RHSResearchLLC/NiteFury-and-LiteFury/images/dsp-metrics.jpg

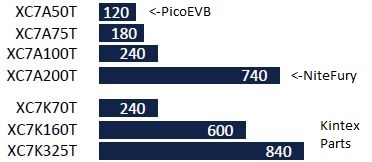
images/dsp-metrics.jpg
