RHSResearchLLC/NiteFury-and-LiteFury/images/on-gh.PNG

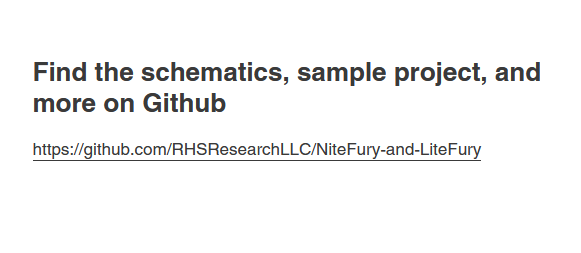
images/on-gh.PNG
