RHSResearchLLC/NiteFury-and-LiteFury/Hardware/uEVB-BOM-Z3.xlsx

RefDes | Quantity | Manufacturer | MPN | Value | Pattern | Name | Desc
C1, C15, C16, C17, C18, C19, C20, C21, C22, C23, C24, C25, C26, C44, C45, C130, C131, C132, C133, C140, C141 | 21 | Samsung | CL05A104JO5NNNC | 0.1uF | C_0402_least_A | CAP_0402 | CAP CER 0.1UF 10V X5R 0402
C2, C3, C4, C27, C28, C29, C30, C56, C57, C58, C59, C68, C69, C70, C71, C72, C73, C74, C75, C87, C88, C89, C90, C91, C92, C96, C97, C98, C99, C100, C103, C104, C105, C108, C109, C110, C111, C114, C115, C116, C117, C120, C121, C122, C123 | 45 | Murata | GRM152R60J474ME15D | 0.47uF | C_0402_least_C | CAP_0402 | CAP CER 0.47UF 6.3V X5R 0402
C5 | 1 | Murata | GJM1555C1H100JB01D | 10pF | C_0402_least | CAP_0402 | CAP CER 10PF 50V C0G/NP0 0402
C6 | 1 | Samsung | CL05C221JB51PNC | 220pF | C_0402_least | CAP_0402 | CAP CER 220PF 50V C0G/NP0 0402
C7, C8, C13, C40, C126, C128, C129, C137, C138, C144, C145, C146, C147 | 13 | Samsung | GRM188R60J476ME15D | 47uF | C_0603_least | CAP_0603 | CAP CER 47UF 6.3V X5R 0603
C9, C10, C11 | 3 | TDK | C1608X5R0J226M080AC | 22uF | C_0603_least | CAP_0603 | CAP CER 22UF 6.3V X5R 0603
C12, C14, C43 | 3 | Kemet | C0402C224K9PAC7867 | 0.22uF | C_0402_least | CAP_0402 | CAP CER 0.22UF 6.3V X5R 0402
C31, C32, C33, C34, C35, C76, C77, C78, C79, C80, C81, C82, C83, C84, C85, C86, C93, C94, C95, C101, C102, C106, C107, C112, C113, C118, C119, C124, C125, C127, C134 | 30 | Murata | GRM153R60J475ME15D | 4.7uF | C_0402_least_B | CAP_0402 | CAP CER 4.7UF 6.3V X5R 0402
C36, C37 | 2 | AVX | F950J107MPAAQ2 | 100uF | CAP_0805 | CAP_0805 | CAP TANT 100UF 6.3V 0805
C38, C39, C41, C42, C54, C55 | 6 | Murata | GRM152R60J105ME15D | 1uF | C_0402_least | CAP_0402 | CAP CER 1UF 6.3V X5R 0402
C46, C47, C48, C49, C50, C51, C52, C53, C60, C61, C62, C63, C64, C65, C66, C67 | 16 | Yageo | CC0201MRX5R5BB104 | 0.1uF | C_0201_least | CAP_0201 | CAP CER 0.1UF 10V X5R 0201
C135, C136 | 2 | Panasonic | ETPH220MABC | 220uF | CAP_1206 | CAP_1206 | CAP TANT POLY 220UF 2.5V 1206
C143 | 1 | Murata | GCM1555C1H220JA16D | 22pF | C_0402_least | CAP_0402 | CAP CER 22PF 50V C0G/NP0 0402
D1 | 1 | Kingbright | APHHS1005SURCK | NOT READY | LED_0402_least | LED-0402
D2, D5, D6, D7, D8 | 5 | Kingbright | APHHS1005CGCK | POWER | LED_0402_least | LED-0402
J1 | 1 | HRS | DF52-20S-0.8H(21) | DF52-20 | DF52-20 | DF52-20
L3, L4 | 2 | Bourns | SRP2510A-R22M | 220nH | L_1008 | L_1008
MH1, MH2, MH3 | 3 |  | DNP | DNP
P1, P2 | 2 | Molex | 78171-5006 |  | PicoEZ-6 | PicoEZMate
P3 | 1 | Molex | 781710002 |  | PicoEZ-2 | PicoEZ-2
P4 | 1 |  |  |  | ACES_3PIN_0.8 | Aces_3
R1, R11, R12, R13, R14, R15 | 6 | Panasonic | ERJ-2RKF49R9X | 49.9 1% | R_0402_least | RES_0402 | RES SMD 49.9 OHM 1% 1/10W 0402
R2, R8, R17, R18, R23, R24 | 6 | Panasonic | ERJ-2RKF6810X | 681 | R_0402_least | RES_0402 | RES SMD 681 OHM 1% 1/10W 0402
R3 | 1 | Panasonic | ERJ-2RKF8871X | 8.87K 0.1% | R_0402_least | RES_0402 | RES SMD 8.87K OHM 1% 1/10W 0402
R4, R25, R30, R31 | 4 | Samsung | RC1005F103CS | 10K 1% | R_0402_least | RES_0402 | RES SMD 10K OHM 1% 1/16W 0402
R5 | 1 | Samsung | RC0603F241CS | 240 1% | R_0201_least | RES_0201 | RES SMD 240 OHM 1% 1/20W 0201
R6, R7, R19, R21, R27, R29, R32 | 7 | Panasonic | ERJ-2RKF4701X | 4.7K | R_0402_least | RES_0402 | RES SMD 4.7K OHM 1% 1/10W 0402
R9, R20 | 1 | Panasonic | ERJ-2RKF1000X | 100 | R_0402_least | RES_0402 | RES SMD 100 OHM 1% 1/10W 0402
R10 | 1 | CTS | RT2402B7TR7 |  | RT24_3x9 | RT2402B7
R16 | 1 | Yageo | RC0201FR-07100RL | 100 | R_0201_least | RES_0201 | RES SMD 100 OHM 1% 1/20W 0201
R22 | 1 | Yageo | RC0402FR-07100KL | 100K 1% | R_0402_least | RES_0402 | RES SMD 100K OHM 1% 1/16W 0402
R26 | 1 | Yageo | RC0402FR-076K98L | 6.98K 1% | R_0402_least | RES_0402 | RES SMD 6.98K OHM 1% 1/16W 0402
R28 | 1 | Yageo | RC0402FR-0713KL | 13K | R_0402_least | RES_0402 | RES SMD 13K OHM 1% 1/16W 0402
TP1-TP18 | 1 |  | DNP | DNP
U1 | 1 | Maxim | MAX1589AETT100+T |  | MAX1589AETT | MAX1589AETT100+T
U2 | 1 | TI | TPS826711SIPR |  | TPS8267x | TPS826711SIPR
U3 | 1 | TI | TPS82085SILR |  | TPS82085 | TPS82085SILR
U5 | 1 | TI | TPS51206DSQ |  | TPS51206 | TPS51206DSQR
U6 | 1 |  | IS43TR16256AL-125KBL |  | TWBGA-96_9X13 | SDRAM x16
U7 | 1 | Xilinx | XC7A200T-3FBG484E |  | BGA-484/22x22x1_23x23 | XC7A200T_FBG484
U8 | 1 | Cypress | S25FL128SAGBHI210 |  | S25FLxxxxxxxxx2xx | S25FL128SAGBHI210
U9 | 1 |  | DNP | DNP
U10 | 1 | Microchip | DSC1001DL2-090.0000 | DSC1001 90MHz | XTAL-2.5x2 | DSC1001
U11 | 1 | TI | TPS82695SIPR |  | TPS8267x | TPS82695
U12 | 1 | TI | TPS8268120SIPR |  | TPS8268120 | TPS8268120
U13 | 1 | ADI | LTC3636EUFD#PBF |  | LTC3636 | LTC3636
X1 | 1 | Abracon | ASDMPLV-200.000MHZ-LR-T | ASDMPLV-200MHZ | XTAL-2.5x2-6 | OSC-6
