RHSResearchLLC/NiteFury-and-LiteFury/(threads)

Thread 2 (2019-09-22):

Enable over-temperature shutdown

HackerFoo, 2019-09-22:
It might be a good idea to enable over-temperature shutdown for Project-0:
```
# XDC Constraint
set_property BITSTREAM.CONFIG.OVERTEMPPOWERDOWN ENABLE [current_design]
```

Which I think is the same as: Edit Device Properties > Configuration > Enable over-termperature shutdown = ENABLE

RHSResearchLLC, 2019-10-29:
Agreed, this is a good idea. I've added the constraint- I'll be checking in new MCS soon. Thanks.

Closed 2019-10-29.

Thread 3 (2019-12-21):

problem during read from c2h in dma-test.py file

shahbaazlokh, 2019-12-21:
Here is the snippet of error:-
"
#0
Sent in 1386.4996433258057 milliseconds (774.4263254366286 MBPS)
Traceback (most recent call last):
  File "dma-test-2.py", line 82, in <module>
    main()
  File "dma-test-2.py", line 69, in main
    mem_test_random()
  File "dma-test-2.py", line 41, in mem_test_random
    rx_data.append(os.pread(fd_c2h, TRANSFER_SIZE, page * TRANSFER_SIZE))
OSError: [Errno 512] Unknown error 512
"
i think this a driver problem,
as i have also tested dma-test.py using earlier drivers from AR65444, c2h hangs in limbo while using this drivers,

Closed 2020-09-03.

Thread 4 (2020-01-25):

Simpler samples please

ianhan, 2020-01-25:
Hi,
This project is really cool but I wasn't expecting the only sample design to be 100% schematic - it would be cool if you could add a sample "golden" top project that consists of an empty verilog top module that implements all of the signals.
Thanks. Thanks for making this cool piece of kit!

mayureshw, 2023-10-28:
I am also looking for a simple sample design. Something like taking the xdma IP xci from the sample project and doing minimal things like loopback with it.

No matter what I try I end up with "!!! Unknown header type 7f" on transferring bitstream to the fpga (and doing rescan also).

I have taken a post implementation checkpoint and dumped the constraints from it just to ensure that those in early.xdc are valid. They are.

What else shall I be checking? Have spent several days in this state and am really at the end of my wits.

RHSResearchLLC, 2023-10-28:
@mayureshw "!!! Unknown header type 7f" happens when the device was on the PCIe bus, then drops off, then comes back on. You can't reprogram the bitstream while the device is on the PCIe bus and expect it to work. I've actually never seen a rescan work, although some people claimed it works for them. For rescan to work you need bios and motherboard support and most just don't implement it.

Really the only reliable way to work on a PCIe bitstream is to have the bitstream loaded from flash at powerup, ready when the motherboard/bios enumerates it, and don't reset/reload the FGPA after. So build your design (with any ILA), create MCS, load into flash, reboot, debug.

As far as a simpler design, the example design is about as simple as it gets. Sure you can delete some the of stuff that reads I/O.

mayureshw, 2023-10-29:
Let's say "mybitstream.bit" is my own design and "stock.bit" is a bitstream built from the sample project design.

I am using JTAG cable to program the device.

If I load, say, "mybitstream.bit" the "Unknown header type" occurs on lspci. But immediately after that if I load "stock.bit", the issue goes away. So, I think you can reprogram the device over JTAG. It is something in the design that keeps "mybitstream.bit" from working.

My Linux kernel is 6.3.13_1 and I am using Void Linux.

For simpler design, yes, that's precisely what I am doing. I have taken xdma configuration (xci file) from the sample project, with early and normal constraints, applied in proper order and verified that they got applied by taking a post-implementation checkpoint and writing out xdc.

With this I expect that lspci merely lists the device properly.

Incidentally there are two xci files for xdma, which confused me a bit:

project.srcs/sources_1/bd/Top/ip/Top_xdma_0_0/Top_xdma_0_0.xci

and

project.srcs/sources_1/bd/Top/ip/Top_xdma_0_0_1/Top_xdma_0_0.xci

Later I saw Top.bd refers to the latter, so that might be the one to pick.

Following is the difference between their properties (right side being the latter one).

`                                                              > all_speeds_all_sides NO
axil_master_64bit_en false                                    | axil_master_64bit_en true
axil_master_prefetchable false                                | axil_master_prefetchable true
axilite_master_scale Megabytes                                | axilite_master_scale Kilobytes
axilite_master_size 1                                         | axilite_master_size 128
                                                              > enable_pcie_debug_ports False
mode_selection Basic                                          | mode_selection Advanced
pf0_base_class_menu Simple_communication_controllers          | pf0_base_class_menu Device_was_built_before_Class_Code_defini
pf0_class_code 070001                                         | pf0_class_code 120000
pf0_class_code_base 07                                        | pf0_class_code_base 12
pf0_class_code_interface 01                                   | pf0_class_code_interface 00
pf0_device_id 7024                                            | pf0_device_id 7011
pf0_msix_cap_pba_bir BAR_1                                    | pf0_msix_cap_pba_bir BAR_3:2
pf0_msix_cap_table_bir BAR_1                                  | pf0_msix_cap_table_bir BAR_3:2
                                                              > pf0_pm_cap_pmesupport_d0 false
                                                              > pf0_pm_cap_pmesupport_d1 false
                                                              > pf0_pm_cap_pmesupport_d3hot false
                                                              > pf0_pm_cap_supp_d1_state false
pf0_sub_class_interface_menu 16450_compatible_serial_controll | pf0_sub_class_interface_menu All_currently_implemented_device
pf0_subsystem_id 0007                                         | pf0_subsystem_id 0
pf0_subsystem_vendor_id 10EE                                  | pf0_subsystem_vendor_id 0
xdma_pcie_64bit_en false                                      | xdma_pcie_64bit_en true
xdma_pcie_prefetchable false                                  | xdma_pcie_prefetchable true
`

mayureshw, 2023-10-29:
One more observation that shows that the new bitstream indeed is what lspci is reporting, I can spot a few small differences between the lspci output of the factory set device and after transferring out.bin. (I expected them to be same, but somehow there are these minor differences.)

<< is factoey set and >> is after transferring out.bin

2c2                                                                                                                                                                                 <       Control: I/O- Mem+ BusMaster+ SpecCycle- MemWINV- VGASnoop- ParErr- Stepping- SERR- FastB2B- DisINTx-                                                                       ---                                                                                                                                                                                 >       Control: I/O- Mem- BusMaster- SpecCycle- MemWINV- VGASnoop- ParErr- Stepping- SERR- FastB2B- DisINTx-                                                                       4d3                                                                                                                                                                                 <       Latency: 0                                                                                                                                                                  7,8c6,7
<       Region 0: Memory at 611c100000 (64-bit, prefetchable) [size=128K]                                                                                                           <       Region 2: Memory at 611c120000 (64-bit, prefetchable) [size=64K]                                                                                                            ---                                                                                                                                                                                 >       Region 0: Memory at 611c100000 (64-bit, prefetchable) [disabled] [size=128K]                                                                                                >       Region 2: Memory at 611c120000 (64-bit, prefetchable) [disabled] [size=64K]                                                                                                 18,19c17,18                                                                                                                                                                         <                       RlxdOrd+ ExtTag+ PhantFunc- AuxPwr- NoSnoop+                                                                                                                <                       MaxPayload 256 bytes, MaxReadReq 512 bytes                                                                                                                  ---                                                                                                                                                                                 >                       RlxdOrd+ ExtTag- PhantFunc- AuxPwr- NoSnoop+                                                                                                                >                       MaxPayload 128 bytes, MaxReadReq 512 bytes

mayureshw, 2023-10-29:
My apologies if the diff output in above two posts looks a little awry. When editing it looks alright and later it messes up with the formating.

Thread 5 (2020-08-05):

Will this work without a heatsink?

shawnl, 2020-08-05:
That massive heatsink will not fit in my thinkpad. On the other hand it has a steel case that it would rest against, and you merged the poweroff on overheat patch.

RHSResearchLLC, 2020-08-13:
Probably not. The Artix FPGAs seem to run hot. Maybe if your bitstream is low power, and you drop to 1 PCIe lane instead of 4, you might have a chance.

Closed 2020-08-13.

Thread 7 (2020-08-20):

PCB design

mmehari, 2020-08-20:
Hi,
Is it possible to have a PCB design of this project, similar to the Kicad project of PicoEVB?

Thanks

RHSResearchLLC, 2020-08-29:
Hello,

I'm not ready to release the PCB design at this time. Plus its a DipTrace project, which isn't as useful as the open-source KiCad project.

Closed 2020-08-29.

Thread 8 (2020-08-30):

Configuring LiteFury

lleon95, 2020-08-30:
Hi,

I am trying to configure the LiteFury with an FT232R connected to the JTAG port of the FPGA. I chose a 3.3V configuration and wiring the FT232R based on the following schematic: http://vak.ru/doku.php/proj/bitbang/bitbang-jtag and the JTAG port pinout from the Litefury [datasheet](https://github.com/RHSResearchLLC/NiteFury-and-LiteFury/blob/master/Hardware/uEVB.pdf).

I installed and built the `xvcd` and it successfully detects the FT232 device similar as I already did for a PicoEVB built-in FT232 device. However, when I connect through Vivado on a remote machine, it tells me that it doesn't detect any Xilinx device within the port (given by `xvcd`).

I would like to ask if you have an example for FT232R wiring to the JTAG port, or in the case, suggest a device to program the Litefury. I connected the Litefury to the PCIe port for NVMM in a Xavier NX, where I am also connecting the FTDI device.

I also want to highlight that I connected the Litefury to the FTDI through the JTAG port without connecting the whole module to the Xavier and a red lights blinked periodically.

Thanks in advance

RHSResearchLLC, 2020-09-03:
Hello,
Unfortunately, I don't have any experience with the FT232R. I use FT230X on PicoEVB, and I've used FT232H with success (but that code uses the MPSSE, not bitbang). I'm sorry I can't be more help.

For programming I usually use Digilent HS1/HS2/HS3. Can usually find them at a decent price

lleon95, 2020-09-03:
Hi. I just wanted to mention I managed to solve the issue. I used this pinout:

```
      -FTDI-  -JTAG-
    -  RXD  -  TDI
    -  TXD  -  TCK
    -  RTS  -  TDO
    -  CTS  -  TMS
    -  DTR  -  TRST
    -  DCD  -  SRST
```

With that, I was able to use the XVCD to configure the Litefury.

Regards,
Leon.

RHSResearchLLC, 2020-09-03:
Awesome thanks for the info!

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

Closed 2020-09-03.

Thread 9 (2020-09-02):

Insufficient mounting stability of 6-pin EZmate connectors

eqvinox, 2020-09-02:
Hiya,

I just managed to tear one of the 6-pin EZmate connectors off the small JTAG adapter boards. Details:

- didn't really use force, used to dealing with small flimsy hardware
- the connector only came off about halfway; both of the side retention pins plus 3 or 4 of the data pins
- the pads were *not* ripped off, it seems the solder connection itself was the weak point
- I successfully soldered it back on manually, but burned some plastic on the JTAG connector since the positioning is awkward

I checked my other adapter (I ordered 2 boards) and at first it seemed to be better, but then on that board also one of the side retention pins came off in the same way, and after this happened the connector doesn't unplug properly anymore (lifts the socket instead.) It seems that as soon as one of the side pins is gone, you're kinda f*cked and the entire thing cascade-fails.

I see 3 possible causes here:

- the solder pads or mask are too small so the solder connection is too weak
- the connectors fundamentally are badly designed (ed.: by Molex, I mean) with a very small area of force transfer
- just bad luck, either on the boards or on my use of them

I'm posting this here as a reference/warning and collection point in case other people have the same problem. I haven't tried/checked this on the actual FPGA boards since I'd rather not break them. Presumably the footprint is the same there, though maybe not the assembly procedure?

Either way it might be a good idea to double check mounting details on these connectors and maybe increase the size of the pads and solder mask opening for the mechanical/mounting pins at the side.

Cheers!

RHSResearchLLC, 2020-09-03:
Hello Hiya,

The issue here is that the first batch (~50 pcs) of the adapter boards were made using low-temp bismuth solder, to prevent the 14-pin connector from melting. Unfortunately, it seems this solder can shear with low force. Bismuth solder was chosen because the assembly has to be lead free for EU, and the 14-pin connector's plastic body would melt at the temperatures required for "standard" (SAC305) lead-free solder.

All subsequent batches use a better 14-pin connector and SAC305 solder, and the solder joint is very strong. The LiteFury/NiteFury itself has always used SAC305 solder so there is no danger of ripping off the connector.

To anyone who experiences this issue, email dave@rhsresearch.com with your address and I'll send you a replacement adapter for free.

eqvinox, 2020-09-07:
> and the 14-pin connector's plastic body would melt at the temperatures required

Can confirm %-)

> The LiteFury/NiteFury itself has always used SAC305 solder so there is no danger of ripping off the connector.

Awesome, very glad to hear that!  That was my primary concern.

> To anyone who experiences this issue, email dave@rhsresearch.com with your address and I'll send you a replacement adapter for free.

Great!  Funnily enough I don't even need the adapter (nothing else I have has 14-pin 2mm JTAG), I was kinda just playing around with it to see how the 6-pin connector works.  So that's 2 pcs that don't need to be replaced.

Closed 2023-10-17.

Thread 10 (2021-02-01):

run_tests.sh locks host machine

BoneGoat, 2021-02-01:
Hi,

I'm running the NiteFury on a RockPi4 (ARM). I had to recompile everything but after that step the kernel module loaded and everything seemed fine. When I ran run_tests.sh the whole machine locked up. Lights are still blinking on the NiteFury but the machine is non responsive. What may cause this?

lspci -vv

01:00.0 Serial controller: Xilinx Corporation Device 7024 (prog-if 01 [16450])
	Subsystem: Xilinx Corporation Device 0007
	Control: I/O- Mem- BusMaster- SpecCycle- MemWINV- VGASnoop- ParErr- Stepping- SERR- FastB2B- DisINTx-
	Status: Cap+ 66MHz- UDF- FastB2B- ParErr- DEVSEL=fast >TAbort- <TAbort- <MAbort- >SERR- <PERR- INTx-
	Interrupt: pin A routed to IRQ 234
	Region 0: Memory at fa000000 (32-bit, non-prefetchable) [disabled] [size=1M]
	Region 1: Memory at fa100000 (32-bit, non-prefetchable) [disabled] [size=64K]
	Capabilities: [40] Power Management version 3
		Flags: PMEClk- DSI- D1- D2- AuxCurrent=0mA PME(D0+,D1+,D2+,D3hot+,D3cold-)
		Status: D0 NoSoftRst+ PME-Enable- DSel=0 DScale=0 PME-
	Capabilities: [48] MSI: Enable- Count=1/1 Maskable- 64bit+
		Address: 0000000000000000  Data: 0000
	Capabilities: [60] Express (v2) Endpoint, MSI 00
		DevCap:	MaxPayload 512 bytes, PhantFunc 0, Latency L0s <64ns, L1 unlimited
			ExtTag+ AttnBtn- AttnInd- PwrInd- RBE+ FLReset- SlotPowerLimit 0.000W
		DevCtl:	Report errors: Correctable- Non-Fatal- Fatal- Unsupported-
			RlxdOrd+ ExtTag- PhantFunc- AuxPwr- NoSnoop+
			MaxPayload 128 bytes, MaxReadReq 512 bytes
		DevSta:	CorrErr- UncorrErr- FatalErr- UnsuppReq- AuxPwr- TransPend-
		LnkCap:	Port #0, Speed 5GT/s, Width x4, ASPM L0s, Exit Latency L0s unlimited, L1 unlimited
			ClockPM- Surprise- LLActRep- BwNot- ASPMOptComp-
		LnkCtl:	ASPM Disabled; RCB 64 bytes Disabled- CommClk-
			ExtSynch- ClockPM- AutWidDis- BWInt- AutBWInt-
		LnkSta:	Speed 2.5GT/s, Width x4, TrErr- Train- SlotClk+ DLActive- BWMgmt- ABWMgmt-
		DevCap2: Completion Timeout: Range B, TimeoutDis-, LTR-, OBFF Not Supported
		DevCtl2: Completion Timeout: 50us to 50ms, TimeoutDis-, LTR-, OBFF Disabled
		LnkCtl2: Target Link Speed: 5GT/s, EnterCompliance- SpeedDis-
			 Transmit Margin: Normal Operating Range, EnterModifiedCompliance- ComplianceSOS-
			 Compliance De-emphasis: -6dB
		LnkSta2: Current De-emphasis Level: -3.5dB, EqualizationComplete-, EqualizationPhase1-
			 EqualizationPhase2-, EqualizationPhase3-, LinkEqualizationRequest-
	Capabilities: [100 v1] Device Serial Number 00-00-00-00-00-00-00-00

sudo ./load_driver.sh

Loading xdma driver...
The Kernel module installed correctly and the xmda devices were recognized.
 DONE

dmesg

[ 7641.378840] xdma: loading out-of-tree module taints kernel.
[ 7641.382338] xdma:xdma_mod_init: Xilinx XDMA Reference Driver xdma v2017.1.47
[ 7641.382351] xdma:xdma_mod_init: desc_blen_max: 0xfffffff/268435455, sgdma_timeout: 10 sec.
[ 7641.383695] xdma:xdma_device_open: xdma device 0000:01:00.0, 0xffffffc0ed638800.
[ 7641.383731] xdma 0000:01:00.0: enabling device (0000 -> 0002)
[ 7641.383757] xdma:pci_check_extended_tag: 0xffffffc0ed638800 EXT_TAG disabled.
[ 7641.383765] xdma:pci_check_extended_tag: pdev 0xffffffc0ed638800, xdev 0xffffffc0e8568000, config bar UNKNOWN.
[ 7641.383931] xdma:map_single_bar: BAR0 at 0xfa000000 mapped at 0xffffff800e400000, length=1048576(/1048576)
[ 7641.383969] xdma:map_single_bar: BAR1 at 0xfa100000 mapped at 0xffffff800bf80000, length=65536(/65536)
[ 7641.383980] xdma:map_bars: config bar 1, pos 1.
[ 7641.383987] xdma:identify_bars: 2 BARs: config 1, user 0, bypass -1.
[ 7641.384198] xdma:probe_one: 0000:01:00.0 xdma0, pdev 0xffffffc0ed638800, xdev 0xffffffc0dd202000, 0xffffffc0e8568000, usr 16, ch 1,1.
[ 7641.409170] xdma:cdev_xvc_init: xcdev 0xffffffc0dd203b88, bar 0, offset 0x40000.

sudo ./run_test.sh

Info: Number of enabled h2c channels = 1
Info: Number of enabled c2h channels = 1
Info: The PCIe DMA core is memory mapped.
Info: Running PCIe DMA memory mapped write read test
      transfer size:  1024
      transfer count: 1
Info: Writing to h2c channel 0 at address offset 0.
Info: Wait for current transactions to complete.

After this the system becomes unresponsive.

RHSResearchLLC, 2021-02-02:
This usually has 2 causes:
1) Old XDMA driver. Don't use the code thats part of this repo. I should probably delete it. You should use the XDMA code from Xilinx GitHub repo here: https://github.com/Xilinx/dma_ip_drivers/tree/master/XDMA/linux-kernel

2) Defective Litefury: If the DDR isn't responding for some reason, it hangs everything. There isn't an AXI timeout.

If you try the new driver and it doesn't solve the problem let me know, I'll send you another Litefury. The units are fully tested before they ship, but stuff happens.

RHSResearchLLC, 2021-02-02:
Also, the best way to get support is via emailing me (dave@rhsresearch.com).

BoneGoat, 2021-02-02:
Thanks for your reply! I built the driver from the repo you posted and it no longer hangs when running run_tests.sh. It does however complete with errors, should I be concerned?

Info: Number of enabled h2c channels = 1
Info: Number of enabled c2h channels = 1
Info: The PCIe DMA core is memory mapped.
Info: Running PCIe DMA memory mapped write read test
      transfer size:  1024
      transfer count: 1
Info: Writing to h2c channel 0 at address offset 0.
Info: Wait for current transactions to complete.
/dev/xdma0_h2c_0 ** Average BW = 1024, 5.287372
Info: Writing to h2c channel 0 at address offset 1024.
Info: Wait for current transactions to complete.
/dev/xdma0_h2c_0 ** Average BW = 1024, 3.657091
Info: Writing to h2c channel 0 at address offset 2048.
Info: Wait for current transactions to complete.
/dev/xdma0_h2c_0 ** Average BW = 1024, 3.771014
Info: Writing to h2c channel 0 at address offset 3072.
Info: Wait for current transactions to complete.
/dev/xdma0_h2c_0 ** Average BW = 1024, 3.803708
Info: Reading from c2h channel 0 at address offset 0.
Info: Wait for the current transactions to complete.
/dev/xdma0_c2h_0 ** Average BW = 1024, 3.376251
Info: Reading from c2h channel 0 at address offset 1024.
Info: Wait for the current transactions to complete.
/dev/xdma0_c2h_0 ** Average BW = 1024, 2.740687
Info: Reading from c2h channel 0 at address offset 2048.
Info: Wait for the current transactions to complete.
/dev/xdma0_c2h_0 ** Average BW = 1024, 4.069499
Info: Reading from c2h channel 0 at address offset 3072.
Info: Wait for the current transactions to complete.
/dev/xdma0_c2h_0 ** Average BW = 1024, 2.467690
Info: Checking data integrity.
data/output_datafile0_4K.bin data/datafile0_4K.bin differ: char 53, line 1
Error: The data written did not match the data that was read.
       address range:   0 - 1024
       write data file: data/datafile0_4K.bin
       read data file:  data/output_datafile0_4K.bin
data/output_datafile1_4K.bin data/datafile1_4K.bin differ: char 53, line 2
Error: The data written did not match the data that was read.
       address range:   1024 - 2048
       write data file: data/datafile1_4K.bin
       read data file:  data/output_datafile1_4K.bin
data/output_datafile2_4K.bin data/datafile2_4K.bin differ: char 54, line 2
Error: The data written did not match the data that was read.
       address range:   2048 - 3072
       write data file: data/datafile2_4K.bin
       read data file:  data/output_datafile2_4K.bin
data/output_datafile3_4K.bin data/datafile3_4K.bin differ: char 53, line 2
Error: The data written did not match the data that was read.
       address range:   3072 - 4096
       write data file: data/datafile3_4K.bin
       read data file:  data/output_datafile3_4K.bin
Error: Test completed with Errors.
Error: Test completed with Errors.

dmesg:
[  870.983951] xdma:xdma_mod_init: Xilinx XDMA Reference Driver xdma v2020.1.8
[  870.983965] xdma:xdma_mod_init: desc_blen_max: 0xfffffff/268435455, timeout: h2c 10 c2h 10 sec.
[  870.985805] xdma:xdma_device_open: xdma device 0000:01:00.0, 0xffffffc0ed678800.
[  870.985876] xdma 0000:01:00.0: enabling device (0000 -> 0002)
[  870.986124] xdma:map_single_bar: BAR0 at 0xfa000000 mapped at 0xffffff800e400000, length=1048576(/1048576)
[  870.986220] xdma:map_single_bar: BAR1 at 0xfa100000 mapped at 0xffffff800bec0000, length=65536(/65536)
[  870.986241] xdma:map_bars: config bar 1, pos 1.
[  870.986259] xdma:identify_bars: 2 BARs: config 1, user 0, bypass -1.
[  870.986728] xdma:pci_keep_intx_enabled: 0000:01:00.0: clear INTX_DISABLE, 0x406 -> 0x6.
[  870.986873] xdma:probe_one: 0000:01:00.0 xdma0, pdev 0xffffffc0ed678800, xdev 0xffffffc0eb376000, 0xffffffc0eb374000, usr 16, ch 1,1.
[  870.997049] xdma:cdev_xvc_init: xcdev 0xffffffc0eb377b88, bar 0, offset 0x40000.

RHSResearchLLC, 2021-02-02:
Tobias,

I don't think the XDMA test you are running will work with the factory
bitstream.

Can you try dma-test-2.py from here:
https://github.com/RHSResearchLLC/NiteFury-and-LiteFury/tree/master/Sample-Projects/Project-0/Host/Host

Best regards,

Dave.

On Tue, Feb 2, 2021 at 2:40 PM Tobias Björnsson <notifications@github.com>
wrote:

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

BoneGoat, 2021-02-08:
Hi, I tried the dma-test-2.py with the following results:

#0
Sent in 2190.97900390625 milliseconds (490.07399070719003 MBPS)
Traceback (most recent call last):
  File "dma-test-2.py", line 81, in <module>
    main()
  File "dma-test-2.py", line 68, in main
    mem_test_random()
  File "dma-test-2.py", line 41, in mem_test_random
    rx_data.append(os.pread(fd_c2h, TRANSFER_SIZE, page * TRANSFER_SIZE))
OSError: [Errno 512] Unknown error 512

Running it again locks up the host.

Error 512 sent me down a rabbit hole with the post here: https://forums.xilinx.com/t5/PCIe-and-CPM/debug-the-driver-of-IP-PCIE-with-DMA/m-p/1003427/highlight/true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

I tested the suggested solution but the test failed anyway:

Info: Number of enabled h2c channels = 1
Info: Number of enabled c2h channels = 1
Info: The PCIe DMA core is memory mapped.
Info: Running PCIe DMA memory mapped write read test
      transfer size:  1024
      transfer count: 1
Info: Writing to h2c channel 0 at address offset 0. TransferSize: 1024 TransferCount: 1
Info: Wait for current transactions to complete.
/dev/xdma0_h2c_0 ** Average BW = 1024, 3.382519
Info: Writing to h2c channel 0 at address offset 1024. TransferSize: 1024 TransferCount: 1
Info: Wait for current transactions to complete.
/dev/xdma0_h2c_0 ** Average BW = 1024, 2.005331
Info: Writing to h2c channel 0 at address offset 2048. TransferSize: 1024 TransferCount: 1
Info: Wait for current transactions to complete.
/dev/xdma0_h2c_0 ** Average BW = 1024, 3.795151
Info: Writing to h2c channel 0 at address offset 3072. TransferSize: 1024 TransferCount: 1
Info: Wait for current transactions to complete.
/dev/xdma0_h2c_0 ** Average BW = 1024, 3.331175
Info: Reading from c2h channel 0 at address offset 0. TransferSize: 1024 TransferCount: 1
Info: Wait for the current transactions to complete.
/dev/xdma0_c2h_0 ** Average BW = 1024, 3.323952
Info: Reading from c2h channel 0 at address offset 1024. TransferSize: 1024 TransferCount: 1
Info: Wait for the current transactions to complete.
/dev/xdma0_c2h_0 ** Average BW = 1024, 3.227494
Info: Reading from c2h channel 0 at address offset 2048. TransferSize: 1024 TransferCount: 1
Info: Wait for the current transactions to complete.
/dev/xdma0_c2h_0 ** Average BW = 1024, 3.982716
Info: Reading from c2h channel 0 at address offset 3072. TransferSize: 1024 TransferCount: 1
Info: Wait for the current transactions to complete.
/dev/xdma0_c2h_0 ** Average BW = 1024, 2.669127
Info: Checking data integrity.
data/output_datafile0_4K.bin data/datafile0_4K.bin differ: char 53, line 1
Error: The data written did not match the data that was read.
       address range:   0 - 1024
       write data file: data/datafile0_4K.bin
       read data file:  data/output_datafile0_4K.bin
data/output_datafile1_4K.bin data/datafile1_4K.bin differ: char 53, line 2
Error: The data written did not match the data that was read.
       address range:   1024 - 2048
       write data file: data/datafile1_4K.bin
       read data file:  data/output_datafile1_4K.bin
data/output_datafile2_4K.bin data/datafile2_4K.bin differ: char 54, line 2
Error: The data written did not match the data that was read.
       address range:   2048 - 3072
       write data file: data/datafile2_4K.bin
       read data file:  data/output_datafile2_4K.bin
data/output_datafile3_4K.bin data/datafile3_4K.bin differ: char 53, line 2
Error: The data written did not match the data that was read.
       address range:   3072 - 4096
       write data file: data/datafile3_4K.bin
       read data file:  data/output_datafile3_4K.bin
Error: Test completed with Errors.
Error: Test completed with Errors.

I'm not sure if the board is faulty or just not compatible with the RockPi4.

RHSResearchLLC, 2021-02-08:
OK, stick with dma-test-2.py. Reduce the transfer size and see if that
helps. Also, once you get that error (unknown error 512), the test won't
work properly. It seems to mess up the driver. So if you see that error 512
its best to reboot and try again. I see that error happen when the transfer
size is too large for the OS to handle.

Best regards,

Dave.

On Mon, Feb 8, 2021 at 2:53 PM Tobias Björnsson <notifications@github.com>
wrote:

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

BoneGoat, 2021-02-09:
Right, tested the following:

1. TRANSFER_SIZE = 512*512*4
2. TRANSFER_SIZE = 256*256*4
3. TRANSFER_SIZE = 128*128*4

All resulted in:

#0
Segmentation fault

dmesg from driver being loaded to the seg fault:

[  169.797974] xdma: loading out-of-tree module taints kernel.
[  169.801380] xdma:xdma_mod_init: Xilinx XDMA Reference Driver xdma v2020.1.8
[  169.801395] xdma:xdma_mod_init: desc_blen_max: 0xfffffff/268435455, timeout: h2c 10 c2h 10 sec.
[  169.802804] xdma:xdma_device_open: xdma device 0000:01:00.0, 0xffffffc0ed5e8000.
[  169.802838] xdma 0000:01:00.0: enabling device (0000 -> 0002)
[  169.803031] xdma:map_single_bar: BAR0 at 0xfa000000 mapped at 0xffffff800e400000, length=1048576(/1048576)
[  169.803070] xdma:map_single_bar: BAR1 at 0xfa100000 mapped at 0xffffff800bec0000, length=65536(/65536)
[  169.803081] xdma:map_bars: config bar 1, pos 1.
[  169.803089] xdma:identify_bars: 2 BARs: config 1, user 0, bypass -1.
[  169.803394] xdma:pci_keep_intx_enabled: 0000:01:00.0: clear INTX_DISABLE, 0x406 -> 0x6.
[  169.803474] xdma:probe_one: 0000:01:00.0 xdma0, pdev 0xffffffc0ed5e8000, xdev 0xffffffc0ed3e4000, 0xffffffc0ed3e6000, usr 16, ch 1,1.
[  169.809281] xdma:cdev_xvc_init: xcdev 0xffffffc0ed3e5b88, bar 0, offset 0x40000.
[  337.868732] Bad mode in Error handler detected, code 0xbf000002 -- SError
[  337.869330] Internal error: Oops - bad mode: 0 [#1] SMP
[  337.869795] Modules linked in: xdma(O) bcmdhd ip_tables x_tables autofs4
[  337.870437] CPU: 4 PID: 784 Comm: python3 Tainted: G           O    4.4.154-59-rockchip-g5e70f14 #4
[  337.871231] Hardware name: ROCK PI 4B (DT)
[  337.871592] task: ffffffc0ed236200 task.stack: ffffffc0eb854000
[  337.872113] PC is at 0x7f80e9a07c
[  337.872404] LR is at 0x47dc78
[  337.872673] pc : [<0000007f80e9a07c>] lr : [<000000000047dc78>] pstate: 40000000
[  337.873318] sp : 0000007ff1d237c0
[  337.873609] x29: 0000007ff1d237c0 x28: 000000003707bc80
[  337.874098] x27: 0000007f80b5d8a0 x26: 000000000047dbd0
[  337.874586] x25: 0000000000000003 x24: 0000000001e00000
[  337.875073] x23: 00000000007c9408 x22: 000000000085e570
[  337.875561] x21: 0000007f80a44480 x20: 0000000036c57ba0
[  337.876048] x19: 0000000000000003 x18: 00000000000002eb
[  337.876535] x17: 0000007f80e9a050 x16: 00000000007c6ad0
[  337.877022] x15: 0000007f80ddce08 x14: 0000007f80dea308
[  337.877510] x13: 000000006022e5a9 x12: 0000000000000018
[  337.877997] x11: 0000000000000000 x10: 0000007ff1d237c0
[  337.878484] x9 : 0000000000000001 x8 : 0000000000000044
[  337.878971] x7 : 0000000000000001 x6 : 0000000000000000
[  337.879458] x5 : 000000000000017f x4 : 0000007f80f31270
[  337.879946] x3 : 0000000001e00000 x2 : 0000000000100000
[  337.880433] x1 : 0000000038eab130 x0 : 0000000000100000
[  337.881062] Process python3 (pid: 784, stack limit = 0xffffffc0eb854000)
[  337.881696] ---[ end trace 3a0bab8d539be790 ]---

RHSResearchLLC, 2021-02-09:
Doesn't look like enough information to really help. Probably the last thing you could try

BoneGoat, 2021-02-10:
OK, thanks Dave for all your help!

Closed 2021-02-10.

Thread 11 (2021-02-15):

Failed to detect XDMA config BAR

spaceotter, 2021-02-15:
I'm having some trouble with my NiteFury card and top-of-master [XDMA](https://github.com/Xilinx/dma_ip_drivers). It works when plugged into a PCIe switch card: https://www.amazon.com/gp/product/B08L8J3MBT/ with some occasional reliability issues. But when plugged into the mother board with a M.2 adapter, the driver doesn't work.

<details>
<summary>lspci -d 10ee: -vvv</summary>

```
4b:00.0 Serial controller: Xilinx Corporation Device 7024 (prog-if 01 [16450])
	Subsystem: Xilinx Corporation Device 0007
	Control: I/O- Mem- BusMaster- SpecCycle- MemWINV- VGASnoop- ParErr- Stepping- SERR- FastB2B- DisINTx-
	Status: Cap+ 66MHz- UDF- FastB2B- ParErr- DEVSEL=fast >TAbort- <TAbort- <MAbort- >SERR- <PERR- INTx-
	Interrupt: pin A routed to IRQ 193
	Region 0: Memory at d0300000 (32-bit, non-prefetchable) [virtual] [size=1M]
	Region 1: Memory at d0400000 (32-bit, non-prefetchable) [virtual] [size=64K]
	Capabilities: [40] Power Management version 3
		Flags: PMEClk- DSI- D1- D2- AuxCurrent=0mA PME(D0+,D1+,D2+,D3hot+,D3cold-)
		Status: D0 NoSoftRst+ PME-Enable- DSel=0 DScale=0 PME-
	Capabilities: [48] MSI: Enable- Count=1/1 Maskable- 64bit+
		Address: 0000000000000000  Data: 0000
	Capabilities: [60] Express (v2) Endpoint, MSI 00
		DevCap:	MaxPayload 512 bytes, PhantFunc 0, Latency L0s <64ns, L1 unlimited
			ExtTag+ AttnBtn- AttnInd- PwrInd- RBE+ FLReset- SlotPowerLimit 0.000W
		DevCtl:	CorrErr- NonFatalErr- FatalErr- UnsupReq-
			RlxdOrd+ ExtTag- PhantFunc- AuxPwr- NoSnoop+
			MaxPayload 128 bytes, MaxReadReq 512 bytes
		DevSta:	CorrErr- NonFatalErr- FatalErr- UnsupReq- AuxPwr- TransPend-
		LnkCap:	Port #0, Speed 5GT/s, Width x4, ASPM L0s, Exit Latency L0s unlimited
			ClockPM- Surprise- LLActRep- BwNot- ASPMOptComp-
		LnkCtl:	ASPM Disabled; RCB 64 bytes Disabled- CommClk-
			ExtSynch- ClockPM- AutWidDis- BWInt- AutBWInt-
		LnkSta:	Speed 5GT/s (ok), Width x4 (ok)
			TrErr- Train- SlotClk+ DLActive- BWMgmt- ABWMgmt-
		DevCap2: Completion Timeout: Range B, TimeoutDis-, NROPrPrP-, LTR-
			 10BitTagComp-, 10BitTagReq-, OBFF Not Supported, ExtFmt-, EETLPPrefix-
			 EmergencyPowerReduction Not Supported, EmergencyPowerReductionInit-
			 FRS-, TPHComp-, ExtTPHComp-
			 AtomicOpsCap: 32bit- 64bit- 128bitCAS-
		DevCtl2: Completion Timeout: 50us to 50ms, TimeoutDis-, LTR-, OBFF Disabled
			 AtomicOpsCtl: ReqEn-
		LnkCtl2: Target Link Speed: 5GT/s, EnterCompliance- SpeedDis-
			 Transmit Margin: Normal Operating Range, EnterModifiedCompliance- ComplianceSOS-
			 Compliance De-emphasis: -6dB
		LnkSta2: Current De-emphasis Level: -6dB, EqualizationComplete-, EqualizationPhase1-
			 EqualizationPhase2-, EqualizationPhase3-, LinkEqualizationRequest-
	Capabilities: [100 v1] Device Serial Number 00-00-00-00-00-00-00-00
```

</details>

<details>
<summary>Result of removing the card in /sys and rescanning</summary>

```
# echo "1" > /sys/bus/pci/devices/0000\:4b\:00.0/remove
# echo "1" > /sys/bus/pci/rescan
[Feb15 12:40] pci 0000:4b:00.0: Removing from iommu group 62
[Feb15 12:41] pcieport 0000:04:08.0: bridge window [mem 0x00100000-0x000fffff] to [bus 05] add_size 200000 add_align 100000
[  +0.000004] pcieport 0000:03:00.0: bridge window [mem 0x00100000-0x001fffff] to [bus 04-05] add_size 200000 add_align 100000
[  +0.000012] pcieport 0000:03:00.0: BAR 14: no space for [mem size 0x00300000]
[  +0.000001] pcieport 0000:03:00.0: BAR 14: failed to assign [mem size 0x00300000]
[  +0.000002] pcieport 0000:03:00.0: BAR 14: no space for [mem size 0x00100000]
[  +0.000001] pcieport 0000:03:00.0: BAR 14: failed to assign [mem size 0x00100000]
[  +0.000001] pcieport 0000:04:08.0: BAR 14: no space for [mem size 0x00200000]
[  +0.000001] pcieport 0000:04:08.0: BAR 14: failed to assign [mem size 0x00200000]
[  +0.000002] pcieport 0000:04:08.0: BAR 14: no space for [mem size 0x00200000]
[  +0.000001] pcieport 0000:04:08.0: BAR 14: failed to assign [mem size 0x00200000]
[  +0.018879] pci 0000:4b:00.0: [10ee:7024] type 00 class 0x070001
[  +0.000023] pci 0000:4b:00.0: reg 0x10: [mem 0xd0300000-0xd03fffff]
[  +0.000010] pci 0000:4b:00.0: reg 0x14: [mem 0xd0400000-0xd040ffff]
[  +0.000105] pci 0000:4b:00.0: PME# supported from D0 D1 D2 D3hot
[  +0.000627] pci 0000:4b:00.0: Adding to iommu group 62
[  +0.000115] pci 0000:4b:00.0: BAR 0: assigned [mem 0xd0300000-0xd03fffff]
[  +0.000004] pci 0000:4b:00.0: BAR 1: assigned [mem 0xd0400000-0xd040ffff]
[Feb15 12:44] xdma:xdma_mod_init: Xilinx XDMA Reference Driver xdma v2020.1.8
[  +0.000002] xdma:xdma_mod_init: desc_blen_max: 0xfffffff/268435455, timeout: h2c 10 c2h 10 sec.
[  +0.000071] xdma:xdma_device_open: xdma device 0000:4b:00.0, 0x0000000045520a28.
[  +0.000001] xdma:alloc_dev_instance: xdev = 0x0000000030361898
[  +0.000003] xdma:xdev_list_add: dev 0000:4b:00.0, xdev 0x0000000030361898, xdma idx 0.
[  +0.000130] xdma:request_regions: pci_request_regions()
[  +0.000005] xdma:map_single_bar: BAR0: 1048576 bytes to be mapped.
[  +0.000025] xdma:map_single_bar: BAR0 at 0xd0300000 mapped at 0x00000000519eaa09, length=1048576(/1048576)
[  +0.000004] xdma:is_config_bar: BAR 0 is NOT the XDMA config BAR: 0xffffffff, 0xffffffff.
[  +0.000001] xdma:map_single_bar: BAR1: 65536 bytes to be mapped.
[  +0.000010] xdma:map_single_bar: BAR1 at 0xd0400000 mapped at 0x0000000071b088e5, length=65536(/65536)
[  +0.000002] xdma:is_config_bar: BAR 1 is NOT the XDMA config BAR: 0xffffffff, 0xffffffff.
[  +0.000001] xdma:map_bars: Failed to detect XDMA config BAR
[  +0.000034] pcieport 0000:40:01.3: DPC: containment event, status:0x1f01 source:0x0000
[  +0.000002] pcieport 0000:40:01.3: DPC: unmasked uncorrectable error detected
[  +0.025532] xdma:probe_one: pdev 0x0000000045520a28, err -22.
[  +0.000003] xdma:xpdev_free: xpdev 0x00000000b9ed515b, destroy_interfaces, xdev 0x0000000000000000.
[  +0.000001] xdma:xpdev_free: xpdev 0x00000000b9ed515b, xdev 0x0000000000000000 xdma_device_close.
[  +0.000001] xdma:xdma_device_close: pdev 0x0000000045520a28, xdev 0x0000000000000000.
[  +0.000006] xdma: probe of 0000:4b:00.0 failed with error -22
[  +0.135983] pcieport 0000:40:01.3: AER: Device recovery failed
```

</details>

I thought, maybe the debugger is holding it in reset. So I built the sample project in 2018.3, which went as expected, then I remove the pcie device, flash the FPGA and add it back. The result is exactly the same.

RHSResearchLLC, 2021-02-15:
Eric,

I'm not 100% sure I understand what you are saying- does it work properly
with 2018.3, or do bother versions have issues?

I have one motherboard where I get a flaky connection if I build using
Vivado 2020. So the bitstream that ships with the board us built using 2018
(I believe) and I've never had any issues with it. When you say M.2
adapter, which adapter are you using? I've tried several passive adapters
and they all seem to work fine.

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

spaceotter, 2021-02-16:
My previous post was only about 2018.3, but I tested 2020.2 as well.
With the pcie switch card:
2018.3 worked.
2020.2 didn't
Without the switch card, using an adapter (not sure what part number) like this one https://www.amazon.com/gp/product/B00MYCQP38
Neither version of vivado works.
Pretty sure the failure mode is always as above.
I could try testing the adapters with an SSD later.

spaceotter, 2021-02-16:
The motherboard is an MSI Creator TRX40. I might have time on Wednesday to test combinations of adapter and maybe another computer. Does the trace above give any hint what might be going wrong?

RHSResearchLLC, 2021-02-16:
Yes it looks like the config space is returning all 0xFFFF. I've seen this happen when the link drops. Even if the link recovers, it seems the config space doesn't.

It would be interesting to try the adapter with SSD. I've never had a problem linking up with adapter or without, when built with 2018 or 2019. I haven't had a chance yet to figure out what the deal is when using 2020. I've tried about 8 different motherboards on a LiteFury built with 2020, and all of them worked fine except for one.

spaceotter, 2021-02-16:
Is the config space in the programmable logic? Why doesn't it get reset by the JTAG?

Closed 2022-08-12.

Thread 12 (2021-04-01):

Fan noise

Mcilie, 2021-04-01:
Please, as awesome as this product is, being powerful and high bandwidth for such a low price, is there a way to make the fan quieter?

RHSResearchLLC, 2021-04-04:
Hello,

Unfortunately, there isn't. The fan is hard-wired, and I have a lot of fans in stock. That said, some fans are noisier than others. Generally I've found "good" fans to be pretty quiet. Maybe you have a bad fan?

If you bought from Amazon, you can try returning for a new one. Or, if you are in the US, send me your email and I can send you a new fan. info@rhsresearch.com.

Mcilie, 2021-04-09:
Its Okay, I decided to keep the unit i have and frankenstein my own fan on to there. The original fan was also going against the airflow direction of my PC, so i guess this is the optimal solution.
Thank you though

suoto, 2021-10-04:
Could you provide a PN for the fan(s) you used so people could source their own? I found a good fan, same size but it's 5V but I don't have noise values, air flow values to compare.

RHSResearchLLC, 2021-10-04:
Hello Andre,

Unfortunately I don't have a part number; it was a custom design.

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

suoto, 2021-10-04:
Do you think this one here: https://noctua.at/en/nf-a4x10-5v/specification would mechanically fit?

gniticxe, 2023-05-01:
I am considering designing an adapter / duct for a replacement fan on the Nitefury.  Mine is mounted on a PCIe expansion card for an otherwise silent desktop.  The Noctua NF-A4x20 5V PWM is a candidate, but would take 2 PCIe slots.  Is there interest in the community for trying my eventual design, or other bits of advice before I begin the design and post to printables.com?

Closed 2022-08-12.

Thread 13 (2021-05-06):

Windows development support

c0ffymachyne, 2021-05-06:
From the files found in the repository I am guessing only Linux is supported, is this correct ?

AEW2015, 2021-05-06:
I have used these boards with Windows using the Xilinx XDMA driver or the Jungo PCIe driver (trail version).  It is possible.

RHSResearchLLC, 2021-05-06:
I'm using the XDMA IP provided by Xilinx, and their drivers; so I don't provide any additional support other than what Xilinx offers. That said, Xilinx does seem to have some support for Windows: https://forums.xilinx.com/t5/PCIe-and-CPM/XDMA-Driver-for-Windows-10/td-p/777694

AEW2015, 2021-05-06:
This is my video shows how to use the Xilinx XDMA drivers on Windows.
https://youtu.be/m56rBYnmxME

c0ffymachyne, 2021-05-06:
Thank you so much ! I will definitely check all those options !

c0ffymachyne, 2021-05-14:
Any chance to have dma-test-2.py script working on windows ?

Thread 14 (2021-06-20):

Picoez to JTAG adapter info

neon5d, 2021-06-20:
Hello,

Can you give more detailed information on what connector types are used for the pico (6 pins) to JTAG (14 pins, 2x7) adapter?
My JTAG cable does not fit the JTAG socket. I need to replace it.
Thank you

RHSResearchLLC, 2021-06-21:
Hello,

Here are the design files (schematic, bill of materials, and gerbers):

[Pico-JTAG-BOM.xlsx](https://github.com/RHSResearchLLC/NiteFury-and-LiteFury/files/6689318/Pico-JTAG-BOM.xlsx)
[Pico-JTAG.pdf](https://github.com/RHSResearchLLC/NiteFury-and-LiteFury/files/6689320/Pico-JTAG.pdf)
[Pico-JTAG-Gerber-X2.zip](https://github.com/RHSResearchLLC/NiteFury-and-LiteFury/files/6689321/Pico-JTAG-Gerber-X2.zip)

RHSResearchLLC, 2021-06-21:
Here is the schematic for the 6-pin Pico-ezmate cable as well

[pjc-1.pdf](https://github.com/RHSResearchLLC/NiteFury-and-LiteFury/files/6689327/pjc-1.pdf)

neon5d, 2021-06-21:
These are what I needed. Thank you.

Closed 2021-06-21.

Thread 15 (2021-07-08):

Building Sample under 2020.2+

wxsatman, 2021-07-08:
[litefury2021mcs.zip](https://github.com/RHSResearchLLC/NiteFury-and-LiteFury/files/6787648/litefury2021mcs.zip)
Some of you out there may have built the sample in this GIT under Vivado 2020.2 which has been the latest version for past 6 months and then tested it to find that the XDMA driver/module refused to load properly, specifically it loaded but could not find the needed Config BAR and therefore did not create any device nodes and was useless.

I recently wrote RHS Research about this to find that XDMA under Vivado 2020.2 was a known issue.       Indeed upon doing a bit of research it appears that the Vivado 2020.2 XDMA IP supplied by Xilinx (RHS research has nothing to do with this) is simply broken at least for all 7 series devices with includes the xc7a100t used on the Lite Fury.

The XDMA IP seems fine up through Vivado 2020.1 and I did indeed create and build an operational project using XDMA for the Lite Fury under 2019.2 that I happened to have on my system.     However the provided sample in this GIT is for 2020.1 and refused to build properly under the older 2019.2.

To date it appears that Xilinx has not fixed the XDMA IP for Vivado 2020.2 although they seem to acknowledge back in March in the Xilinx way that there is a problem!

However Vivado 2021.1 was just released so I installed it (Ubuntu 20.04 is officially supported) and attempted to build the sample under it.

The build mostly went fine.     Make sure you upgrade the IP and allow Vivado to use the new directory structure it will ask about these when open your clone of this GIT project.     The only real issue I had is upon initial build it had 15 critical warnings this was because it was very confused about the GTP transceiver placement for PCIe that is specialized for the Lite/Nite Fury!

This is a complex issue that mostly involves the order it processes two different constraint files.    If it is processing in the intended order you should end up with 3 critical warnings and the GTP mapping should be X0Y7 on pipe_lane[3],  X0Y6 on pipe_lane[0], X0Y5 on pipe_lane[2], and X0Y4 on pipe_lane[1].   The critical warnings should indicate the above mapping, read these carefully.

Anyway upon initial build it was using the constraints in wrong order resulting in 15 critical warnings.   I found (at least in my case) that if you edit the XDMA IP in block diagram (I changed the PCI ID from 0x7011 to 0x7012) and save block design.    Then rebuild the XDMA IP and then the whole project (takes a while) and I ended up with the proper 3 critical warnings and the proper GTP mapping.    However I will critically (to Xilinx) warn that I am not sure if this trick is consistent or why it works!

Anyway upon successful build I put the MCS file into flash on a Lite Fury power cycled the victim computer and tested with “Xilinx XDMA Reference Driver xdma v2020.1.8” which as of July 7th is the latest XDMA driver from Xilinx.    At least the key DMA transfers to the Lite Fury RAM seemed to work fine.   I did not test the other peripherals in the sample project build but will next week and report if there are issues.

I have attached the mcs file I built with Vivado 2021.1 for Lite Fury once programmed AND power cycled lspci should show Lite Fury as 10EE:7012.

RHSResearchLLC, 2021-07-10:
Wow thanks for thi! @wxsatman !

RHSResearchLLC, 2022-08-12:
Latest release now updated for Vivado 2022.1, which seems to work

Thread 16 (2021-07-11):

LVDS connection (DF52-20P)

neon5d, 2021-07-11:
Hello,

I am trying to connect DF52-20P.
The right part is DF52-20P-0.8C.
I used the cable (DF52-2832PF157).
The cable is quite expensive and it has an individual cable for 20 pins.
Do you have any other solution for the DF52-20P connection?
Thank you,

RHSResearchLLC, 2021-07-12:
Hello neon5d,

Unfortunately I don't have another solution. Mouser used to sell a pre-built 20-pin cable, but they don't anymore; they just sell individual pre-crimped leads.

neon5d, 2021-07-12:
Thank you for confirmation.

Closed 2021-07-12.

Thread 17 (2021-08-17):

Flashing/program via PCIe

dannycoin, 2021-08-17:
Hi there..

1) can an acorn 215+ / Litefury be flashed through PCIe without JTAG cable?
2) is it mandatory to use a JTAG cable to flash/program?
3) Is there a guide to flashing via PCIe?
3) Can I design in tools like Vivado and then flash / program via PCIe?

RHSResearchLLC, 2021-08-17:
1. Yes, but only if there is already a bitstream that supports this. See https://github.com/RHSResearchLLC/NiteFury-and-LiteFury/tree/master/spi-loader
2. Only if you don't already have a compatible bitstream running
3. See https://github.com/RHSResearchLLC/NiteFury-and-LiteFury/tree/master/spi-loader
4. You can use Vivado to create .mcs, then load that MCS using the spi-loader

The factory 215+ bitstream probably won't work with the spi-loader (not sure). But the factory NiteFury bitstream should.

Finally, you can also use a FTDI for programming, with OpenOCD. Vivado doesn't recognize FTDI but OpenOCD does. I don't have an example for NiteFury, but here is an example for PicoEVB, which is similar: https://github.com/RHSResearchLLC/PicoEVB/tree/master/spi-flash-program-openocd

Gbps, 2022-10-06:
I wrote up a guide here using the above info, hopefully this can help:
https://github.com/Gbps/nitefury-openocd-flashing-guide

RHSResearchLLC, 2022-10-06:
Nice! I tried this same exact thing but it didn't seem to work, and I gave up rather quickly. Now that I think about it, I was trying on a blank flash, which probably wasn't properly configured. *Furys that have been programmed once have the flash preconfigured. Maybe I'll integrate your work with that caveat. Thanks again for this nice writeup!

Thread 18 (2021-08-23):

Enable over-temperature shutdown for LiteFury

trosenkranz, 2021-08-23:
As already asked in #2, please also enable over-temperature shutdown for the LiteFury sample project. (Sample-Projects/Project-0/FPGA-A100T-2/)

Thanks
Tobias

RHSResearchLLC, 2022-08-12:
Fixed in latest release- over-temperature shutdown enabled

Closed 2022-08-12.

Thread 19 (2022-10-07):

Early processing property not working in Vivado Linux

VHWeng, 2022-10-07:
Basically Vivado in Windows works fine. The problem is using Vivado in Linux. The PCIe pins are miss-placed.  Vivado reports an error in synthesis: _[Project 1-236] Implementation specific constraints were found while reading constraint file [ …/constraints/early.xdc]. These constraints will be ignored for synthesis but will be used in implementation. Impacted constraints are listed in the file [.Xil/Top_wrapper_propImpl.xdc]._
To fix this problem, I rebuild the build script in Linux to resets the LCO property on the PCIe cell and add the correct LCO. A couple of points, the synthesis needs to be opened to make the change. But you can’t close it. Closing it will lose the change or reset the synthesis. Close the design after implementation (see attached) .

I'm using the Vivado 2022.1 Any idea?

VH

[build_mod.zip](https://github.com/RHSResearchLLC/NiteFury-and-LiteFury/files/9729745/build_mod.zip)

RHSResearchLLC, 2022-10-07:
If it works different on Linux than Windows, its a Vivado issue. I can't remember if I used Linux or Windows to build the factory bitstreams. At any rate, there are "Early", constraints which are processed first, and those should be pinning the location of the transceiver BEL. Make sure the properties for the early constraints file has the processing order set to "early"
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

VHWeng, 2022-10-08:
Yes, this seems like it’s a Xilinx Vivado issue. I posted this mostly to see if anyone else was having the same problem. I recheck the early processing order, and it is set to early. I’m using Ubuntu 20.04 (_Linux XLinux 5.15.0-48-generic #54~20.04.1-Ubuntu SMP Thu Sep 1 16:17:26 UTC 2022 x86_64 x86_64 x86_64 GNU/Linux)_ with Vivado 2021.1.

Bobo1239, 2022-10-29:
I've also noticed this issue with Vivado 2021.1 running on (Arch) Linux. My workaround was to set the processing order of `Top_xdma_0_0_pcie2_ip-PCIE_X0Y0.xdc` to  NORMAL. (not sure if this causes any other issues). But indeed seems like a Vivado bug and should be reported to XiIinx.

quizitlive, 2022-12-19:
I've had the issue with Vivado 2022.2 on Ubuntu 22.04.1 -- I had to change the `Top_xdma_0_0_pcie2_ip-PCIE_X0Y0.xdc to NORMAL too. However, as well as the expected 3 critical warnings, I get another, that it failed to meet timing violations -- related to Inter-Clock Path Setup userclk2 to mmcm_clkout0  (related to he CodeBlinker). Is this related to other contraints being applied in the wrong order?

RHSResearchLLC, 2022-12-19:
@quizitlive no the timing violation warning for codeblinker is unrelated.

teknoman117, 2024-02-05:
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

I have the same issue running Vivado 2022.1 and 2023.2 on Gentoo Linux.

If anyone stumbles across this issue and was lost on how exactly to make that change:

1. Run the "rebuild.tcl" script (or run synthesis & implementation). The constraints file won't be visible until that is run
2. Go to the "Sources" pane
3. Click the "IP Sources" tab
4. Hit the search button (top left of pane)
5. Type "Top_xdma_0_0_pcie2_ip-PCIE_X0Y0"
6. Select the xdc file that comes up
7. Go to the "Source File Properties" pane
8. Click the "Properties" tab
9. Change the "PROCESSING_ORDER" property to "NORMAL"
10. Run the "build.tcl" script (or run synthesis & implementation again)

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

Thread 20 (2023-01-24):

lspci -vvv -s 01:00.0 displays  "Unknown Header Type 7F"

bipingamiyv, 2023-01-24:
Hi, I am using NITEFURY 2(Artix-7 xc7a200tfbg484-2) and created the design with XDMA IP. I am programming the board through JTAG only.

1.  I loaded the bin file provided by RHSResearchLLC(https://github.com/RHSResearchLLC/NiteFury-and-LiteFury/tree/master/Sample-Projects/Project-0/FPGA/Nitefury-II/mcs) through JTAG it worked. Device was detecting in pcie.
2. Then i generate the bitfile and loaded it thorough JTAG. lspci -vvv -s 01:00.0 displays "Unknown Header Type 7F". I tried this command echo 1 > /sys/bus/pci/rescan also, but still lspci -vvv -s 01:00.0 displays "Unknown Header Type 7F"
3. Again i loaded their original bin file. It worked. Device was detecting in pcie bus.
4. Then i created the binfile (using my bitfile) by following (write_cfgmem -format bin -size 16 -interface SPIx4 -force -loadbit "up 0 ./project.runs/impl_1/Top_wrapper.bit" -file "../mcs/out.bin")  and loaded it to board through JTAG. Again lspci -vvv -s 01:00.0 displays "Unknown Header Type 7F". I tried this command  echo 1 > /sys/bus/pci/rescan also, but still lspci -vvv -s 01:00.0 displays "Unknown Header Type 7F"

I am using the same XDMA IP configuration as provided in sample project,.

These are the questions I have,

1.     Is the binfile packaging I am doing (write_cfgmem -format bin -size 16 -interface SPIx4 -force -loadbit "up 0 ./project.runs/impl_1/Top_wrapper.bit" -file "../mcs/out.bin") is correct ?
2. Not sure why loading bitfile via JTAG also doesnt work ? Is there any linux command I need to run to re-enumerate the PCI device ?

RHSResearchLLC, 2023-01-24:
That "Unknown Header Type..." error usually occurs when the Nitefury is enumerated on the bus (at host boot time) but then drops off and comes back. This will happen when you reload bitfile or reprogram flash via JTAG.

The solution is to re-enumerate the bus. However, in practice, I've never seen this work. I've tried dozens of systems and have yet to see `echo 1 > /sys/bus/pci/rescan` work.

Sorry I can't be more helpful.

bipingamiyv, 2023-01-31:
Thanks for your response.

We packaged the bitfile using the script and loaded via JTAG.

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

Is the binfile packaging I am doing (write_cfgmem -format bin -size 16 -interface SPIx4 -force -loadbit "up 0 ./project.runs/impl_1/Top_wrapper.bit" -file "../mcs/out.bin") is correct ?

bipingamiyv, 2023-02-07:
It's done.

mayureshw, 2023-10-20:
I came across "Unknown Header Type 7F".

A basic question: When you see "Unknown Header Type 7F" does the design work? i.e. is this just a cosmetic issue that can be ignored or it leads to any problem with the driver?

bipingamiyv, 2023-10-22:
"Vivado initially sets the processing order of 'Top_xdma_0_0_pcie2_ip-PCIE_X0Y0.xdc' to 'EARLY' by default. However, I changed the order to  'NORMAL,' which resolved the issue."

You can reffer to the below link also:
[https://github.com/RHSResearchLLC/NiteFury-and-LiteFury/issues/19](url)

Closed 2023-02-07.

Thread 21 (2023-02-21):

OpenOCD flashing failing with "Haven't made progress in mpsse_flush"

Gbps, 2023-02-21:
Hey there,

I don't know if you've experienced this yet, but I had no problems flashing the board over JTAG prior to the issue happening now. I have the same setup, same programmer, same cord, etc. and the only thing that's changed is that I upgraded my motherboard/cpu on my main desktop which is doing the programming.

It appears that the device is resetting mid-programming. After a series of reboots and power cycles I did get it to program a few times, although now it's back to doing this and I haven't been able to get a successful reprogram.

Openocd is running in an ubuntu server 22.04 VM under VMWare workstation with the USB being passed through to the guest.

There's a lot of things that could be going wrong here, but hoping maybe someone has seen this before and figured out what was going on. It could just be I need to replace the cable or something to that effect.

Output from openocd:
```
Tue Feb 21 05:35:15 PM UTC 2023
Open On-Chip Debugger 0.12.0-rc1
Licensed under GNU GPL v2
For bug reports, read
        http://openocd.org/doc/doxygen/bugs.html
Info : auto-selecting first available session transport "jtag". To override use 'transport select <transport>'.
Info : clock speed 1000 kHz
Info : JTAG tap: xc7.tap tap/device found: 0x13636093 (mfg: 0x049 (Xilinx), part: 0x3636, ver: 0x1)
Writing BSCAN_SPI bitstream...
Info : JTAG tap: xc7.tap tap/device found: 0x13636093 (mfg: 0x049 (Xilinx), part: 0x3636, ver: 0x1)
Info : Found flash device 'sp s25fl256s' (ID 0x190201)
Warn : 4-byte addresses needed, might need extra command to enable
Programming PCIe Chainloader bitstream to SPI...
Info : sector 0 took 1770 ms
Info : sector 1 took 1722 ms
Info : sector 2 took 112 ms
Info : sector 3 took 106 ms
Info : sector 4 took 108 ms
Info : sector 5 took 112 ms
Info : sector 6 took 106 ms
Info : sector 7 took 117 ms
Info : sector 8 took 107 ms
Info : sector 9 took 102 ms
Info : sector 10 took 111 ms
Info : sector 11 took 104 ms
Info : sector 12 took 105 ms
Info : sector 13 took 106 ms
Info : sector 14 took 107 ms
Info : sector 15 took 117 ms
Info : sector 16 took 116 ms
Info : sector 17 took 108 ms
Info : sector 18 took 110 ms
Info : sector 19 took 109 ms
Info : sector 20 took 107 ms
Info : sector 21 took 115 ms
Info : sector 22 took 106 ms
Info : sector 23 took 113 ms
Info : sector 24 took 110 ms
Info : sector 25 took 103 ms
Info : sector 26 took 111 ms
Info : sector 27 took 104 ms
Info : sector 28 took 113 ms
Info : sector 29 took 120 ms
Info : sector 30 took 105 ms
Info : sector 31 took 111 ms
Info : sector 32 took 111 ms
Info : sector 33 took 111 ms
Info : sector 34 took 107 ms
Info : sector 35 took 117 ms
Info : sector 36 took 117 ms
Info : sector 37 took 113 ms
Info : sector 38 took 110 ms
Info : sector 39 took 111 ms
Info : sector 40 took 106 ms
Info : sector 41 took 109 ms
Info : sector 42 took 111 ms
Info : sector 43 took 106 ms
Info : sector 44 took 104 ms
Info : sector 45 took 102 ms
Info : sector 46 took 104 ms
Info : sector 47 took 130 ms
Info : sector 48 took 114 ms
Info : sector 49 took 117 ms
Warn : Haven't made progress in mpsse_flush() for 2003ms.
Warn : Haven't made progress in mpsse_flush() for 4005ms.
Warn : Haven't made progress in mpsse_flush() for 8006ms.
Warn : Haven't made progress in mpsse_flush() for 16011ms.
Warn : Haven't made progress in mpsse_flush() for 32022ms.
Warn : Haven't made progress in mpsse_flush() for 64042ms.
Warn : Haven't made progress in mpsse_flush() for 128085ms.
```

The configuration file:
```
reset_config none

source [find interface/ftdi/digilent_jtag_hs3.cfg]
source [find cpld/xilinx-xc7.cfg]
source [find cpld/jtagspi.cfg]

adapter speed 1000

proc fpga_program {} {
        global _CHIPNAME
        xc7_program $_CHIPNAME.tap
}

init
echo "Writing BSCAN_SPI bitstream..."
jtagspi_init 0 bscan_spi_xc7a200t.bit
echo "Programming PCIe Chainloader bitstream to SPI..."
jtagspi_program pcie-chainloader-project0.bin 0x0
echo "Resetting device..."
fpga_program
echo "Done."
shutdown
```

And openocd version:
```
Open On-Chip Debugger 0.12.0-rc1
Licensed under GNU GPL v2
For bug reports, read
        http://openocd.org/doc/doxygen/bugs.html
```

RHSResearchLLC, 2023-02-21:
Hello Gbps,
I have never seen this issue. How do you know the Litefury is rebooting? Does the power or 'done' LED flicker? That error message implies the libusb function call isn't returning- which could be a lot of things, especially when using USB through a VM. That said I use a VM with USB all the time and don't usually have trouble.

Gbps, 2023-02-21:
Hey thanks for the quick reply. I didn't note in the previous post, but this is a Nitefury 2 board. I don't actually know that it is resetting, to be honest, so that might be bad information and just an assumption.

As a last ditch effort, I just dug out a new microusb cable for my programmer and gave that a shot. So far, it has not failed programming yet. I did some scientific method and confirmed that the usb port, clock speed, power state, pcie slot, all of those things remained consistent but just swapping out the cord to the old cord caused this issue and the new cord did not have the issue.

I think it's safe enough to say that something happened to this microusb cord resulting in this. I doubt the tolerances on these Amazon cords are particularly good so I can imagine over time something has resulted in the cord causing libusb to disconnect.

Thank you for taking a look!

Closed 2023-02-21.

Thread 22 (2023-03-02):

Sample project won't build: PCIe ports missing?

mablinov, 2023-03-02:
Hi all, I'm on Windows 10 using a freshly-installed Vivado 2022.2.

I'm failling on the bitstream generation step of the [sample project](https://github.com/RHSResearchLLC/NiteFury-and-LiteFury/tree/master/Sample-Projects/Project-0/FPGA/Nitefury-II/project), with the following error:

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

There's also a ton of warnings about `'set_property' expects atleast one object`, which look like this:

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

In the picture above, I noticed that the "Ports" drop-down menu doesn't have anything relating to PCIe, other than `pci_reset`, and `pcie_clkreq_I` - is that expected? Shouldn't I be seeing the PCIe lane signals in the top-level Ports listing?

Another thing of note: I did get a dialogue asking me to migrate from Vivado 2022.1 (which I did), and when opening the `Top.bd` block design file, I got a prompt that 9 IP blocks needed updating. Updating them went through almost without a hitch apart from one warning:

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

Anyway, I'm still fiddling with the project, but I'm posting here in the hopes that maybe someone can catch something that I can't see?

mablinov, 2023-03-02:
After having read back my own post, I think I'm confusing two separate issues: The critical warnings, and the actual bitstream generation failure.

The actual bitstream generation failure error is not referencing any PCIe signals. Infact it is referencing the following signals:
 - `code[2:0]`
 - `clk`
 - `led`
 - `ok`

It's worth mentioning that I have no clue what or where these signals even come from - They're not anywhere in the board design (that I can see), but if I click the hyperlinked `code[2:0]` field in the error report, I get taken to a device view where I am offered to set a default signal type:

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

I just set these to LVCMOS33, save the settings back to the `normal.xdc` constraints file when prompted to do so, and then re-run the implementation step followed by the bitstream generation step.

This got rid of one error: However, the "Port placement" error remained:

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

I'm going to try to figure out where these signals are even coming from. Looking at the top-level board design file, I can't visually see where or who is instantiating those signals by those names:

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

mablinov, 2023-03-02:
Ok, I found the issue! I wasn't even building the `Top.bd` design: I was building the `CodeBlinker.v` example!

```verilog
...

module CodeBlinker(
    input clk,
	input ok,
	input [2:0] code,
	output reg led
    );

...
```

Vivado definitely had some kind of crazy bug: I clicked "Refresh hierarchy" in the "Sources" tab, and "Top_wrapper" magically became the "Top" design file:

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

I can confirm that Vivado detected the changes by asking about "details" of why its out of date:

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

Going to re-run everything and post results

mablinov, 2023-03-03:
Ok, here's my full findings and resolution:

(TL;DR: Before doing anything, upgrade *all* IP blocks, and then you *must* "Refresh Hierarchy" for changes to take effect.)

When you first open the project in Vivado 2022.2, and you accept the offer to migrate the project, you will actually be staring at a semi-broken project. The top module, `Top_module.v`, will be coloured in red, because it doesn't exist:

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

Vivado evidently then falls-back by setting the next module as the top-level module, which in this case is the `CodeBlinker.v` module.

If you right-click on the board design file to re-generate the top-level wrapper, you will get the following error:

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

The reason they're locked is because they are out of date, and Vivado insists that you open the "Report IP Status" tool to update them.

So go ahead and update the blocks, but after it finishes you *must* click "Refresh Hierarchy" by right-clicking on the "Design Sources" folder in the "Sources" tab. *Then* the top-level wrapper gets created, and Vivado finally figures out that *that* is what we're trying to build.

After that, do the full synth -> implementation -> bitstream flow, and it should work.

Closed 2023-03-03.

Thread 23 (2023-03-03):

Where to find/how to change "board version" (aka `board_pvrsn`)?

mablinov, 2023-03-03:
Probably a stupid question, but I can't figure out where to find the right value to put for the "board version" parameter that is required for the [`furytest.sh`](https://github.com/RHSResearchLLC/NiteFury-and-LiteFury/blob/master/Sample-Projects/Project-0/Host/fury-test.sh) script.

In the [`test-general.py`](https://github.com/RHSResearchLLC/NiteFury-and-LiteFury/blob/9fc9f1bae6c06523d46470fc309b73e7015aa9fd/Sample-Projects/Project-0/Host/test-general.py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) its referred to as the `board_vrsn` parameter. I added a line to print out the `pvrsn` read back from the board, and it appears to be assigned to `2` - Where is this configured from the Vivado side of things?

RHSResearchLLC, 2023-03-03:
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

RHSResearchLLC, 2023-03-03:
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

mablinov, 2023-03-03:
Got it, thanks!

Closed 2023-03-03.

Thread 25 (2023-04-17):

Timing Violations with LiteFury on Vivado 2022.1

dwilliamson, 2023-04-17:
With 2022.1 on Windows and the latest version of this repo, I am getting the 3 expected critical warnings, as well as some timing violations:

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

These are from Inter-Clock Paths `userclk2` to `mmcm_clkout0` (GPIO to CodeBlinker):

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

I have updated to this specific version as you mentioned at https://github.com/RHSResearchLLC/NiteFury-and-LiteFury/issues/15#issuecomment-1213275575 that the release is supported. Are you seeing this as well?

Thanks,
\- Don

RHSResearchLLC, 2023-04-24:
I haven't tried 2022.1. I don't see any timing violations when I build it.

dwilliamson, 2023-04-26:
How can you not see any timing violations when you build it if you haven't tried 2022.1? If it requires updating to 2022.2 then I'm happy with that. This also happens with a clean build on the NiteFury project.

Anyway, our currently supported Vivado version is 2019.1 so I simply went back 2 or 3 years in this repo to get everything working for me.

Thanks,
- Don

Chester-Gillon, 2023-05-29:
> With 2022.1 on Windows and the latest version of this repo, I am getting the 3 expected critical warnings, as well as some timing violations:
> These are from Inter-Clock Paths `userclk2` to `mmcm_clkout0` (GPIO to CodeBlinker):

Just to say I get the same timing violations on the same Inter-Clock Paths `userclk2` to `mmcm_clkout0` paths when built the latest version of **NiteFury** with 2022.1 on Windows.  I haven't yet investigated the significance of the timing violations, but after loading the built bitstream over JTAG (i.e. left the flash unchanged) basic functionality worked:
1. Read the NiteFury identity from the GPIO registers.
2. A test of the DDR passed.
3. Read the temperature and voltages from the XADC.

Chester-Gillon, 2023-06-04:
> With 2022.1 on Windows and the latest version of this repo, I am getting the 3 expected critical warnings, as well as some timing violations:
> These are from Inter-Clock Paths `userclk2` to `mmcm_clkout0` (GPIO to CodeBlinker):

Looking at the _Methodology_  tab in Vivado there is critical warning which contains ``TIMING #2 Critical Warning The clocks userclk2 and mmcm_clkout0 are related (timed together) but they have no common primary clock. The design could fail in hardware. To find a timing path between these clocks, run the following command: report_timing -from [get_clocks userclk2] -to [get_clocks mmcm_clkout0] ``

Running the suggested command in the TCL Console results in:
```
report_timing -from [get_clocks userclk2] -to [get_clocks mmcm_clkout0]
INFO: [Timing 38-91] UpdateTimingParams: Speed grade: -2, Delay Type: max.
INFO: [Timing 38-191] Multithreading enabled for timing update using a maximum of 2 CPUs
INFO: [Timing 38-78] ReportTimingParams: -from_pins  -to_pins  -max_paths 1 -nworst 1 -delay_type max -sort_by slack.
WARNING: [Timing 38-164] This design has multiple clocks. Inter clock paths are considered valid unless explicitly excluded by timing constraints such as set_clock_groups or set_false_path.
Copyright 1986-2022 Xilinx, Inc. All Rights Reserved.
-----------------------------------------------------------------------------------------
| Tool Version : Vivado v.2022.1 (win64) Build 3526262 Mon Apr 18 15:48:16 MDT 2022
| Date         : Sun Jun  4 13:47:05 2023
| Host         : DESKTOP-EG5EBI0 running 64-bit major release  (build 9200)
| Command      : report_timing -from [get_clocks userclk2] -to [get_clocks mmcm_clkout0]
| Design       : Top_wrapper
| Device       : 7a200t-fbg484
| Speed File   : -2  PRODUCTION 1.23 2018-06-13
-----------------------------------------------------------------------------------------

Timing Report

Slack (VIOLATED) :        -2.210ns  (required time - arrival time)
  Source:                 Top_i/GPIO_regs/axi_gpio_2/U0/gpio_core_1/Dual.gpio2_Data_Out_reg[27]/C
                            (rising edge-triggered cell FDRE clocked by userclk2  {rise@0.000ns fall@4.000ns period=8.000ns})
  Destination:            Top_i/CodeBlinker_3/inst/s_code_reg[2]/D
                            (falling edge-triggered cell FDRE clocked by mmcm_clkout0  {rise@0.000ns fall@5.000ns period=10.000ns})
  Path Group:             mmcm_clkout0
  Path Type:              Setup (Max at Slow Process Corner)
  Requirement:            1.000ns  (mmcm_clkout0 fall@25.000ns - userclk2 rise@24.000ns)
  Data Path Delay:        0.641ns  (logic 0.379ns (59.094%)  route 0.262ns (40.906%))
  Logic Levels:           0
  Clock Path Skew:        -2.257ns (DCD - SCD + CPR)
    Destination Clock Delay (DCD):    3.738ns = ( 28.738 - 25.000 )
    Source Clock Delay      (SCD):    5.995ns = ( 29.995 - 24.000 )
    Clock Pessimism Removal (CPR):    0.000ns
  Clock Uncertainty:      0.289ns  ((TSJ^2 + DJ^2)^1/2) / 2 + PE
    Total System Jitter     (TSJ):    0.071ns
    Discrete Jitter          (DJ):    0.266ns
    Phase Error              (PE):    0.151ns
  Clock Domain Crossing:  Inter clock paths are considered valid unless explicitly excluded by timing constraints such as set_clock_groups or set_false_path.

    Location             Delay type                Incr(ns)  Path(ns)    Netlist Resource(s)
  -------------------------------------------------------------------    -------------------
                         (clock userclk2 rise edge)
                                                     24.000    24.000 r
    GTPE2_CHANNEL_X0Y6   GTPE2_CHANNEL                0.000    24.000 r  Top_i/xdma_0/inst/Top_xdma_0_0_pcie2_to_pcie3_wrapper_i/pcie2_ip_i/inst/inst/gt_top_i/pipe_wrapper_i/pipe_lane[0].gt_wrapper_i/gtp_channel.gtpe2_channel_i/TXOUTCLK
                         net (fo=1, routed)           1.274    25.274    Top_i/xdma_0/inst/Top_xdma_0_0_pcie2_to_pcie3_wrapper_i/pcie2_ip_i/inst/inst/gt_top_i/pipe_wrapper_i/pipe_clock_int.pipe_clock_i/txoutclk_i.txoutclk_i_0
    BUFGCTRL_X0Y20       BUFG (Prop_bufg_I_O)         0.081    25.355 r  Top_i/xdma_0/inst/Top_xdma_0_0_pcie2_to_pcie3_wrapper_i/pcie2_ip_i/inst/inst/gt_top_i/pipe_wrapper_i/pipe_clock_int.pipe_clock_i/txoutclk_i.txoutclk_i/O
                         net (fo=1, routed)           1.520    26.874    Top_i/xdma_0/inst/Top_xdma_0_0_pcie2_to_pcie3_wrapper_i/pcie2_ip_i/inst/inst/gt_top_i/pipe_wrapper_i/pipe_clock_int.pipe_clock_i/refclk
    MMCME2_ADV_X0Y2      MMCME2_ADV (Prop_mmcme2_adv_CLKIN1_CLKOUT3)
                                                      0.077    26.951 r  Top_i/xdma_0/inst/Top_xdma_0_0_pcie2_to_pcie3_wrapper_i/pcie2_ip_i/inst/inst/gt_top_i/pipe_wrapper_i/pipe_clock_int.pipe_clock_i/mmcm_i/CLKOUT3
                         net (fo=1, routed)           1.559    28.510    Top_i/xdma_0/inst/Top_xdma_0_0_pcie2_to_pcie3_wrapper_i/pcie2_ip_i/inst/inst/gt_top_i/pipe_wrapper_i/pipe_clock_int.pipe_clock_i/userclk2
    BUFGCTRL_X0Y0        BUFG (Prop_bufg_I_O)         0.081    28.591 r  Top_i/xdma_0/inst/Top_xdma_0_0_pcie2_to_pcie3_wrapper_i/pcie2_ip_i/inst/inst/gt_top_i/pipe_wrapper_i/pipe_clock_int.pipe_clock_i/userclk2_i1.usrclk2_i1/O
                         net (fo=22601, routed)       1.404    29.995    Top_i/GPIO_regs/axi_gpio_2/U0/gpio_core_1/s_axi_aclk
    SLICE_X93Y139        FDRE                                         r  Top_i/GPIO_regs/axi_gpio_2/U0/gpio_core_1/Dual.gpio2_Data_Out_reg[27]/C
  -------------------------------------------------------------------    -------------------
    SLICE_X93Y139        FDRE (Prop_fdre_C_Q)         0.379    30.374 r  Top_i/GPIO_regs/axi_gpio_2/U0/gpio_core_1/Dual.gpio2_Data_Out_reg[27]/Q
                         net (fo=2, routed)           0.262    30.636    Top_i/CodeBlinker_3/inst/code[2]
    SLICE_X93Y138        FDRE                                         r  Top_i/CodeBlinker_3/inst/s_code_reg[2]/D
  -------------------------------------------------------------------    -------------------

                         (clock mmcm_clkout0 fall edge)
                                                     25.000    25.000 f
    J19                                               0.000    25.000 f  sys_clk_clk_p (IN)
                         net (fo=0)                   0.000    25.000    Top_i/mig_7series_0/u_Top_mig_7series_0_0_mig/u_ddr3_clk_ibuf/sys_clk_p
    J19                  IBUFDS (Prop_ibufds_I_O)     0.820    25.820 f  Top_i/mig_7series_0/u_Top_mig_7series_0_0_mig/u_ddr3_clk_ibuf/diff_input_clk.u_ibufg_sys_clk/O
                         net (fo=2, routed)           1.019    26.839    Top_i/mig_7series_0/u_Top_mig_7series_0_0_mig/u_ddr3_infrastructure/out
    PLLE2_ADV_X0Y3       PLLE2_ADV (Prop_plle2_adv_CLKIN1_CLKOUT3)
                                                      0.074    26.913 f  Top_i/mig_7series_0/u_Top_mig_7series_0_0_mig/u_ddr3_infrastructure/plle2_i/CLKOUT3
                         net (fo=1, routed)           1.064    27.977    Top_i/mig_7series_0/u_Top_mig_7series_0_0_mig/u_ddr3_infrastructure/pll_clk3_out
    BUFHCE_X0Y36         BUFH (Prop_bufh_I_O)         0.069    28.046 f  Top_i/mig_7series_0/u_Top_mig_7series_0_0_mig/u_ddr3_infrastructure/u_bufh_pll_clk3/O
                         net (fo=1, routed)           0.794    28.840    Top_i/mig_7series_0/u_Top_mig_7series_0_0_mig/u_ddr3_infrastructure/pll_clk3
    MMCME2_ADV_X0Y3      MMCME2_ADV (Prop_mmcme2_adv_CLKIN1_CLKOUT0)
                                                     -2.964    25.876 f  Top_i/mig_7series_0/u_Top_mig_7series_0_0_mig/u_ddr3_infrastructure/gen_ui_extra_clocks.mmcm_i/CLKOUT0
                         net (fo=1, routed)           1.488    27.364    Top_i/mig_7series_0/u_Top_mig_7series_0_0_mig/u_ddr3_infrastructure/mmcm_clkout0
    BUFGCTRL_X0Y18       BUFG (Prop_bufg_I_O)         0.077    27.441 f  Top_i/mig_7series_0/u_Top_mig_7series_0_0_mig/u_ddr3_infrastructure/gen_ui_extra_clocks.u_bufg_ui_addn_clk_0/O
                         net (fo=44, routed)          1.297    28.738    Top_i/CodeBlinker_3/inst/clk
    SLICE_X93Y138        FDRE                                         r  Top_i/CodeBlinker_3/inst/s_code_reg[2]/C  (IS_INVERTED)
                         clock pessimism              0.000    28.738
                         clock uncertainty           -0.289    28.449
    SLICE_X93Y138        FDRE (Setup_fdre_C_D)       -0.023    28.426    Top_i/CodeBlinker_3/inst/s_code_reg[2]
  -------------------------------------------------------------------
                         required time                         28.426
                         arrival time                         -30.636
  -------------------------------------------------------------------
                         slack                                 -2.210

report_timing: Time (s): cpu = 00:00:25 ; elapsed = 00:00:12 . Memory (MB): peak = 4222.516 ; gain = 53.934
```
Haven't yet determined what to change to fix the timing violations.

Closed 2023-04-26.

Thread 26 (2023-06-25):

About NiteFury with Integrated Heatsink from crowd supply.

mopplayer, 2023-06-25:
Hi, is there any difference between NiteFury-II and NiteFury-I (NiteFury with Integrated Heatsink from crowd supply)?

I have seen that it only has 512MB DDR3 on board, right?
Are there other changes?

Thank you very much.

RHSResearchLLC, 2023-06-25:
Hello,

The main difference is the heatsink: the -II has a large heatsink. The
original design is discontinued; the heatsink didn't work well enough and
it was a lot of labor to assemble.

Other than that, the design is the same, aside from various
bill-of-materials only changes (DDR capacity, FPGA, etc)

Best regards,

Dave

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

Closed 2023-08-17.

Thread 27 (2023-08-10):

NiteFurry II with M.2 case

WannaBeKratos, 2023-08-10:
Is it possible to take the heat sink off and put it in a case like this one [DOCKCASE](https://www.amazon.com/DOCKCASE-Visual-Enclosure-Support-Prevents/dp/B09Z2CFDYQ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) and have it work via USB ?

Closed 2023-08-17.

Thread 28 (2023-09-04):

Would Nitefurry fit in Intel NUC 13?

mayureshw, 2023-09-04:
I have ordered Nitefurry, but yet to order a suitable SBC / PC with M.2 M key slot.

Considering Intel NUC-13 i7. It has a M.2 M key slot, but not sure about whether it will accommodate the height, considering the heat sink.

Please suggest alternative SBCs otherwise.

mayureshw, 2023-09-04:
Please confirm, the given dimension, 22x80x28mm, is inclusive of heat sink. Right?

RHSResearchLLC, 2023-09-04:
Yes those dimensions include the heatsink. I don't know if it fits in a NUC-13. Let me know if it does. Thanks

mayureshw, 2023-09-11:
Nope :-(

It produces out by about 5mm or so. (Didn't actually measure with a scale.)

Also removed, the Sata casing on the lid but that doesn't help.

But I am still going to use it by keeping the bottom lid open, keeping the NUC upside down! Barring the fitting issue it seems a good combination - NUC + Nitefurry.

Closed 2023-09-11.

Thread 29 (2023-09-11):

How to know if your device is recognized by the OS

mayureshw, 2023-09-11:
I have a fresh (i.e. with factory settings) NiteFury device in NUC 13 running Void Linux.

I just want to know if the device is at least physically set properly and to some extent recognized by the OS. Do the following indicators help? Is there something else (say in dmesg) that can be checked?

Is Vivado HW manager likely to recognize it (over PCIe)?

```
# dmidecode
Handle 0x001A, DMI type 9, 17 bytes
System Slot Information
        Designation: M2_A
        Type: x4 PCI Express 3 x4
        Current Usage: In Use
        Length: Long
        ID: 0
        Characteristics:
                3.3 V is provided
                Opening is shared
                PME signal is supported
        Bus Address: 0000:00:1d.0
```
```
# lspci -vvv
01:00.0 Processing accelerators: Xilinx Corporation 7-Series FPGA Hard PCIe block (AXI/debug)
        Control: I/O- Mem- BusMaster- SpecCycle- MemWINV- VGASnoop- ParErr- Stepping- SERR- FastB2B- DisINTx-
        Status: Cap+ 66MHz- UDF- FastB2B- ParErr- DEVSEL=fast >TAbort- <TAbort- <MAbort- >SERR- <PERR- INTx-
        Interrupt: pin A routed to IRQ 255
        IOMMU group: 15
        Region 0: Memory at 611c100000 (64-bit, prefetchable) [disabled] [size=128K]
        Region 2: Memory at 611c120000 (64-bit, prefetchable) [disabled] [size=64K]
        Capabilities: [40] Power Management version 3
                Flags: PMEClk- DSI- D1- D2- AuxCurrent=0mA PME(D0+,D1+,D2+,D3hot+,D3cold-)
                Status: D0 NoSoftRst+ PME-Enable- DSel=0 DScale=0 PME-
        Capabilities: [48] MSI: Enable- Count=1/1 Maskable- 64bit+
                Address: 0000000000000000  Data: 0000
        Capabilities: [60] Express (v2) Endpoint, MSI 00
                DevCap: MaxPayload 512 bytes, PhantFunc 0, Latency L0s <64ns, L1 unlimited
                        ExtTag+ AttnBtn- AttnInd- PwrInd- RBE+ FLReset- SlotPowerLimit 75W
                DevCtl: CorrErr- NonFatalErr- FatalErr- UnsupReq-
                        RlxdOrd+ ExtTag+ PhantFunc- AuxPwr- NoSnoop+
                        MaxPayload 256 bytes, MaxReadReq 512 bytes
                DevSta: CorrErr- NonFatalErr- FatalErr- UnsupReq- AuxPwr- TransPend-
                LnkCap: Port #0, Speed 5GT/s, Width x4, ASPM L0s, Exit Latency L0s unlimited
                        ClockPM- Surprise- LLActRep- BwNot- ASPMOptComp-
                LnkCtl: ASPM Disabled; RCB 64 bytes, Disabled- CommClk+
                        ExtSynch- ClockPM- AutWidDis- BWInt- AutBWInt-
                LnkSta: Speed 5GT/s, Width x4
                        TrErr- Train- SlotClk+ DLActive- BWMgmt- ABWMgmt-
                DevCap2: Completion Timeout: Range B, TimeoutDis- NROPrPrP- LTR-
                         10BitTagComp- 10BitTagReq- OBFF Not Supported, ExtFmt- EETLPPrefix-
                         EmergencyPowerReduction Not Supported, EmergencyPowerReductionInit-
                         FRS- TPHComp- ExtTPHComp-
                         AtomicOpsCap: 32bit- 64bit- 128bitCAS-
                DevCtl2: Completion Timeout: 50us to 50ms, TimeoutDis- LTR- 10BitTagReq- OBFF Disabled,
                         AtomicOpsCtl: ReqEn-
                LnkCtl2: Target Link Speed: 5GT/s, EnterCompliance- SpeedDis-
                         Transmit Margin: Normal Operating Range, EnterModifiedCompliance- ComplianceSOS-
                         Compliance Preset/De-emphasis: -6dB de-emphasis, 0dB preshoot
                LnkSta2: Current De-emphasis Level: -6dB, EqualizationComplete- EqualizationPhase1-
                         EqualizationPhase2- EqualizationPhase3- LinkEqualizationRequest-
                         Retimer- 2Retimers- CrosslinkRes: unsupported
        Capabilities: [100 v1] Device Serial Number 00-00-00-00-00-00-00-00

```

RHSResearchLLC, 2023-09-11:
If the device shows up in lspci, it is up and recognized by the OS. Lnksta indicates the negotiated link: In this case Gen 2 (5GT/s), 4 lanes. Perfect.

mayureshw, 2023-09-11:
Thanks for the confirmation.

Is there any documentation of what the factory set design actually does? Is some sort of a loop test possible over PCIe?

Closed 2023-09-12.

Thread 30 (2023-09-12):

Programming NiteFury with fallback to factory set design

mayureshw, 2023-09-12:
I have a NiteFury decvice. I do not have a JTAG cable. So do not want to land into a situation where NiteFury is `bricked'.

Is there any way to leave the factory design untouched or any way to recover it if overwritten (without a JTAG cable)?

I have another board - Digilent Arty - where I transfer bitstream to the device over a Microusb cable. I think it doesn't flash the device as I can always reboot to the factory set design. Can I use NiteFury in this way to always restore it into factory reset state?

mayureshw, 2023-09-13:
I think there is no option but to buy JTAG cable.

It looks a bit costly. Is this a passive cable i.e. just wires or it contains any circuit? I wonder if I can get it made from a vendor who creates custom cables.

mayureshw, 2023-09-13:
Alright, looks like it's best to buy the Digilent HS3, despite its costs.

Closed 2023-09-13.

Thread 31 (2023-09-13):

How do you fix the JTAG cable to NiteFury?

mayureshw, 2023-09-13:
I can see the picture on the home page of this git repo.

But as you fix the device in an M Key slot, the pads where the wires are shown as placed face downward to the motherboard and there is hardly any gap to pull them out from such position. If someone can show a picture of how this is fixed that will be of great help.

mayureshw, 2023-09-13:
UPDATE: The cable that ships with Nitefurry fitted fine under the card.

Closed 2023-09-13.

Thread 32 (2023-09-21):

Which partname to set for NiteFury: XC7A200T-2FBG484E or XC7A200T-FBG484

mayureshw, 2023-09-21:
Readme of this repository shows XC7A200T-2FBG484E, but Vivado rejects this as invalid partname when creating bitstream. (I am using all tcl scripts, no UI.)

In the following xdc file in this repository I found partname XC7A200T-FBG484
Sample-Projects/Project-0/FPGA/Nitefury-II/project/project.srcs/sources_1/bd/Top/ip/Top_mig_7series_0_0/Top_mig_7series_0_0/example_design/par/example_top.xdc

This is accepted by Vivado, but a simple design to just switch on or off an LED is transferred to the expected effect on LED doesn't happen.

In my Vivado installation I find following partnames with string fbg484

xc7a200tfbg484-1
xc7a200tfbg484-2
xc7a200tfbg484-2L
xc7a200tfbg484-3
xc7a200tifbg484-1L
xc7a200tlfbg484-2L

get_property PART [current_hw_device]
shows xc7a200t

This partname is accepted, but still I am unable to get any indication on the LEDs.

In my design I have just set '1' on LED_A1 through LED_A4 and LED_M2. I have used constraint files copied from this directory: Sample-Projects/Project-0/FPGA/Nitefury-II/project/project.srcs/constrs_1/imports/constraints

Some of the sample projects in this repo show: xc7a200tfbg484-2. With that also, I don't seem to get the LEDs lit.

My Vivado version is:  v2022.2

mayureshw, 2023-09-21:
Ah! '0' means ON for LED on this board. I can now control LED_A*

But what about LED_M2, it doesn't seem to matter whether I set it to '1' or '0'.

RHSResearchLLC, 2023-10-17:
xc7a200tfbg484-2 is the right part.

The LED_M2 is not on the board- it toggles the LED line on the M.2 connector, which usually isn't connected to anything. Some motherboards will pin this to a header or LED.

Closed 2023-10-17.

Thread 33 (2023-10-15):

Interfacing ADC with Nitefury II via DF52

neerajkc, 2023-10-15:
The LVDS lines on the DF52 connector interface to pins that are not clock capable (none of the pins are MRCC/SRCC). I could see DQS lanes though in the two banks. Is there a way I can use the DF52 lanes to interface a high speed multichannel ADC?
It's a 65MSPS ADC in serial LVDS mode and outputs a data_clock, frame_clock, and data. I need to use ISERDES2 primitives to deserialise the data into 12-bit samples.

RHSResearchLLC, 2023-10-17:
They aren't clock-capable but they are LVDS pairs. I'm not familiar with that chip but yeah if you need 3 LVDS pairs to interface to it, you should have no problem

Closed 2023-10-17.

Thread 34 (2023-10-17):

Nitefury + USB4 / USB-C

peppergrayxyz, 2023-10-17:
Hi,

any plans to create an updated version with USB4/USB-C connector?

RHSResearchLLC, 2023-10-17:
Hello,

I haven't thought about it. I'll check and see if it's electrically
possible. Likely there is an additional protocol layer, like Thunderbolt.
So it's probably not possible to use the GT to connect to USB4 directly.

Take care,

Dave

On Tue, Oct 17, 2023, 10:36 AM peppergrayxyz ***@***.***>
wrote:

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

Thread 38 (2023-10-21):

Is loading of Top_wrapper.bit over JTAG supposed to work?

mayureshw, 2023-10-21:
The sample project build produces the following bitstream file:

NiteFury-and-LiteFury/Sample-Projects/Project-0/FPGA/Nitefury-II/project/project.runs/impl_1/Top_wrapper.bit

Then I am transferring this to the hardware over JTAG using Tcl command: program_hw_devices.

This leads to lspci showing: "Unknown header type 7f"

"echo 1 > /sys/bus/pci/rescan" doesn't help here.

Invoking load_driver afresh leads to

Error: The Kernel module installed correctly, but no devices were recognized.
 FAILED

What exactly is the issue here - is .bit file supposed to work? Is it an issue with re-scanning not happening properly? Or something else?

mayureshw, 2023-10-22:
Would like to mention that I have built the sample project on Vivado 2022.2. I had to invoke upgrade_ip to upgrade the ips to the current version. That's the only 'change' if at all to the sample design.

mayureshw, 2023-10-22:
This is quite like the following issue. Can @bipingamiyv please share what the fix was. It will be immensely useful to all users of nitefury. The comment just says "it's done".

https://github.com/RHSResearchLLC/NiteFury-and-LiteFury/issues/20#issuecomment-1420478783

mayureshw, 2023-10-22:
As illustrated in this[1] article, 'reset' does not solve the problem

remove + rescan also does not solve it

In fact after 'remove' if I reboot the host, the device doesn't show up in lspci again. It shows up again only after power cycle.

[1] https://cubiclenate.com/2019/10/31/power-cycling-pcie-devices-from-the-command-line/

mayureshw, 2023-10-22:
Update: If I use the stock bitstream from the github repo i.e. NiteFury-and-LiteFury/Sample-Projects/Project-0/FPGA/Nitefury-II/mcs/out.bin "echo 1 > /sys/bus/pci/rescan" DOES work and it restores the lspci output.

So there is something wrong with the bitstream built using Vivado 2022.2. What is it? Is any IP broken? Has anyone succeeded in getting the stock design work under 2022.2?

My steps to build were:

1. open_project project.xpr. This automatically upgrades the project to current vivado version.
2. upgrade_ip [get_ips]. This was needed as recommended during above step to upgrade the ips to the current version
3. ../../common/Scripts/rebuild.tcl (as advised on this github project page)

The stock bin file has size 3235252 bytes and the newly generated by above step has size 3050500 bytes.

mayureshw, 2023-10-22:
If I compare what configurable options changed in IP Top_xdma_0_0 due to upgrade_ip, the following new options appear with their default values.

                                                              > all_speeds_all_sides NO
                                                              > enable_pcie_debug_ports False
                                                              > pf0_pm_cap_pmesupport_d0 false
                                                              > pf0_pm_cap_pmesupport_d1 false
                                                              > pf0_pm_cap_pmesupport_d3hot false
                                                              > pf0_pm_cap_supp_d1_state false

mayureshw, 2023-10-23:
Sharing what I did, in case someone hits this page.

Thanks @bipingamiyv for confirming that the issue relates with early constraints. However I did not find the generated xdc file in project.xpr to changes its order to normal. I am a entirely command line user and have never launched GUI.

In build.tcl to launch_runs command I added option -scripts_only

This generated script Top_wrapper.tcl

In this script, just before place_design I added 'source pre-place.tcl'

In pre-place.tcl I placed the LOC constraints from early.xdc and before them I just added reset_property for the same cells.

Now the generated bitstream works for me. Even tried "remove and rescan". On remove lspci output goes away and on rescan it comes back. So things are working now.

Closed 2023-10-23.

Thread 39 (2023-10-24):

What would constitute a minimal project to merely detect the device in lspci

mayureshw, 2023-10-24:
What part of the sample project would be sufficient for the OS detect the device?

Would configuring xdma ip and adding the xdc constraints be enough (including taking care of "early" constraints)? Or what you do with AXI  and AXI-Lite ports matters to merely being detected by the OS?

mayureshw, 2023-10-31:
Trying a stream mode loopback. Will ask more specific questions separately.

Closed 2023-10-31.

Thread 40 (2023-10-31):

Has anyone tried streaming mode loopback with NiteFury?

mayureshw, 2023-10-31:
My attempt is recorded here. Please share inputs and experience if anyone has tried this:

https://support.xilinx.com/s/question/0D54U00007auyteSAA/streaming-mode-loopback-using-xdma-ip-on-artix-7series-device

mayureshw, 2023-10-31:
Have updated the thread at above link. It kind of works now. But the only problem is after every test I have to rmmod and insmod the xdma driver. After doing so only the first test (i.e. the dma_streaming_test test driver of xdma) works and then it starts failing - some driver state issue.

So, not really a nitefury issue, but may be of interest to the nitefury users' community.

If there is any organized community (such as mailing list, reddit forum etc.) of nitefury users (other than on github here) please let me know.

I'll keep this issue open for a few days and then close.

Closed 2023-11-10.

Thread 42 (2023-12-09):

NiteFury II / Ubuntu 22.04 / Envoy Express Thunderbolt - Success

timkpaine, 2023-12-09:
Just wanted to post for others who might be looking, pretty successful with the following devices (taking note of https://github.com/RHSResearchLLC/NiteFury-and-LiteFury/issues/19 when you want to make changes).

- Fine on [m.2 nvme adapter](https://www.amazon.com/gp/product/B07JJTVGZM) / vanilla xilinx xdma drivers
- Fine on [a standard thundebolt nvme enclosure](https://eshop.macsales.com/shop/envoy-express/thunderbolt-3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) (but note that this might be motherboard dependent, only one of my two thunderbolt ports will work on [my motherboard](https://www.gigabyte.com/Motherboard/GA-Z170X-UD5-TH-rev-10#ov)  )

I will test soon if it works on an M1 Macbook passthrough to Ubuntu via UTM.

teknoman117, 2024-02-05:
This enclosure also worked for me (Both a LiteFury and an Acorn CLE-215+)

https://www.amazon.com/Enclosure-Aluminum-External-Support-Compatible/dp/B0BBZT42HC

vrbadev, 2024-11-10:
I have recently bought the Nitefury board from Amazon and I am currently testing it with [this Hagibis NVMe enclosure](https://www.shophagibis.com/products/usb4-m-2-nvme-ssd-enclosure-with-led-display-hb777). It contains ASM2464PD chip which should be capable of PCIe Gen4 x4. So I thought it could be used the same way as the usually recommended enclosures with Intel chipsets JHL6340, JHL7540, JHL7440 etc.
The thing is that when I connect it, I do not see any change in `lsusb` nor `lspci` output. In output of `dmesg` I get only `ucsi_acpi USBC000:00: UCSI_GET_PDOS failed (-95)` which is probably related to failing power delivery negotiation. Could anybody confirm what the expected outputs are, and if the enclosure I am testing is compatible?
Also, the enclosure reaches approx. 80˚C quickly even with the default bitstream flashed - is that normal? My Digilent HS2 JTAG programmer sometimes keeps reconnecting every cca 1s in the Vivado Hardware Manager with this message: `HW Target shutdown. Closing target: localhost:3121/xilinx_tcf/Digilent/210249BAC3B8` - can it be caused by some temperature protection or is the board/programmer just faulty?

Closed 2023-12-09.

Thread 43 (2023-12-31):

Where to buy Nitefury without cooling

WannaBeKratos, 2023-12-31:
Hi, Is it possible to buy the nitefury without the cooling glued on ? I would like to use custom cooling solution.

RHSResearchLLC, 2024-01-01:
Hello,

I don't sell it without a heatsink. If you are very careful, you may be
able to remove the heatsink. It helps to heat the unit up to about 100C.

On Sun, Dec 31, 2023 at 7:48 AM WannaBeKratos ***@***.***>
wrote:

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

Thread 44 (2024-01-02):

How to handle constraints files?

Gandalf1783, 2024-01-02:
Hey!

I got the Litefury model and during designing my VHDL code I remebered the constrains file.

AFAIK, the constraints are used to set the physical constraints of the FPGA.
However, can I just drop them into ANY project?

Or do I have to refactor some properties in there?

In my case, I did not take a look onto the default projects.

**TLDR**: Are the constraints files (early/normal.xdc) project-dependent, a "must-have" in every project or not necessary at all when going to generate and flash the bitstream onto the FPGA?

Thanks!

RHSResearchLLC, 2024-01-03:
Hello,

In general constraint files are necessary for every project. Xilinx lets you put all sorts of stuff in constaints files- like physical constraints, timing constraints, and settings for properties like bitstream generation.

"Early" constraint files take effect before "Normal" and "Late". In this project, the early constraints are necessary because the XDMA IP tries to locate the transceivers in a certain spot, which doesn't match up with the wiring on the hardware. And once they are loc'd, the tool won't re-loc when it comes across a new constraint for the same entity. So the early constraint file "locks in" the location of the transceivers for PCIe.

Gandalf1783, 2024-01-04:
Ahh that clears some things up!

Thanks!

Closed 2024-01-04.

Thread 47 (2024-02-03):

Questions about the flashing using SPI Loader

Mark1626, 2024-02-03:
I recently brought the Nitefury II board and I'm looking forward to using it. Currently it has the factory default bitstream. I installed the xdma kernel module, the board is detected and I was able to run the example to identify the board.

I currently don't have a JTAG, and it won't be arriving for about a week or so. Meanwhile I wanted to know if I can use the spi-loader on the factory default bitstream. When I run the [spi-loader test](https://github.com/RHSResearchLLC/NiteFury-and-LiteFury/blob/master/spi-loader/linux/sw/test/test1.sh) it freezes after `Initializing flash index 0`. Any idea why this is happening?

```
$ ./spi-loader -a 0x240000 -f ./64KiB.bin
Loading 65536 bytes from ./64KiB.bin[0] to flash[2359296] using /dev/xdma0_user[65536]

Initializing flash index 0...
```

**Other questions about the flashing over PCIe using the spi-loader:**

1. Which address should I write a new bitstream into?
2. Will I have to overwrite the existing bitstream everytime?

---

Result of **lspci**

```
07:00.0 Processing accelerators: Xilinx Corporation 7-Series FPGA Hard PCIe block (AXI/debug)
	Control: I/O- Mem+ BusMaster+ SpecCycle- MemWINV- VGASnoop- ParErr- Stepping- SERR- FastB2B- DisINTx-
	Status: Cap+ 66MHz- UDF- FastB2B- ParErr- DEVSEL=fast >TAbort- <TAbort- <MAbort- >SERR- <PERR- INTx-
	Latency: 0, Cache Line Size: 64 bytes
	Interrupt: pin A routed to IRQ 39
	IOMMU group: 26
	Region 0: Memory at e2100000 (64-bit, prefetchable) [size=128K]
	Region 2: Memory at e2120000 (64-bit, prefetchable) [size=64K]
	Capabilities: [40] Power Management version 3
		Flags: PMEClk- DSI- D1- D2- AuxCurrent=0mA PME(D0+,D1+,D2+,D3hot+,D3cold-)
		Status: D0 NoSoftRst+ PME-Enable- DSel=0 DScale=0 PME-
	Capabilities: [48] MSI: Enable- Count=1/1 Maskable- 64bit+
		Address: 0000000000000000  Data: 0000
	Capabilities: [60] Express (v2) Endpoint, MSI 00
		DevCap:	MaxPayload 512 bytes, PhantFunc 0, Latency L0s <64ns, L1 unlimited
			ExtTag+ AttnBtn- AttnInd- PwrInd- RBE+ FLReset- SlotPowerLimit 0.000W
		DevCtl:	CorrErr- NonFatalErr- FatalErr- UnsupReq-
			RlxdOrd+ ExtTag+ PhantFunc- AuxPwr- NoSnoop+
			MaxPayload 128 bytes, MaxReadReq 512 bytes
		DevSta:	CorrErr- NonFatalErr- FatalErr- UnsupReq- AuxPwr- TransPend-
		LnkCap:	Port #0, Speed 5GT/s, Width x4, ASPM L0s, Exit Latency L0s unlimited
			ClockPM- Surprise- LLActRep- BwNot- ASPMOptComp-
		LnkCtl:	ASPM Disabled; RCB 64 bytes, Disabled- CommClk+
			ExtSynch- ClockPM- AutWidDis- BWInt- AutBWInt-
		LnkSta:	Speed 5GT/s (ok), Width x1 (downgraded)
			TrErr- Train- SlotClk+ DLActive- BWMgmt- ABWMgmt-
		DevCap2: Completion Timeout: Range B, TimeoutDis- NROPrPrP- LTR-
			 10BitTagComp- 10BitTagReq- OBFF Not Supported, ExtFmt- EETLPPrefix-
			 EmergencyPowerReduction Not Supported, EmergencyPowerReductionInit-
			 FRS- TPHComp- ExtTPHComp-
			 AtomicOpsCap: 32bit- 64bit- 128bitCAS-
		DevCtl2: Completion Timeout: 50us to 50ms, TimeoutDis- LTR- OBFF Disabled,
			 AtomicOpsCtl: ReqEn-
		LnkCtl2: Target Link Speed: 5GT/s, EnterCompliance- SpeedDis-
			 Transmit Margin: Normal Operating Range, EnterModifiedCompliance- ComplianceSOS-
			 Compliance De-emphasis: -6dB
		LnkSta2: Current De-emphasis Level: -6dB, EqualizationComplete- EqualizationPhase1-
			 EqualizationPhase2- EqualizationPhase3- LinkEqualizationRequest-
			 Retimer- 2Retimers- CrosslinkRes: unsupported
	Capabilities: [100 v1] Device Serial Number 00-00-00-00-00-00-00-00
	Kernel driver in use: xdma
	Kernel modules: xdma
```

---

**Result of test-general**

```sh
$ python test-general.py -v 2 -i NITE
Found product ID b'NITE' version 2
Temp C=55.0
VCCInt=1.02
vccaux=1.80
Checkout passed

```

---

**Other info**

```
OS: AlmaLinux 9.3 (Shamrock Pampas Cat) x86_64
Kernel: 5.14.0-362.8.1.el9_3.x86_64
```

Mark1626, 2024-02-19:
Closing this as I'm going with a JTAG to program the board

Closed 2024-02-19.

Thread 48 (2024-02-07):

Works on StarFive VisionFive 2

teknoman117, 2024-02-07:
Not an issue, just wanted to share that NiteFury & LiteFury work on a VisionFive 2! The XDMA driver worked nearly out of the box with the Ubuntu 23.10 image (had to make a few changes for kernel 6.5, xdma only supports 6.1 at the moment). Board only has a gen. 2 x1 connection to the M.2 connector though.

(I made some changes to use the Acorn CLE-215+ since it's a NiteFury-II with the -3 rather than the -2 speedgrade part. Also added a 1 MiB block ram to the AXI DMA fabric so that I could see how fast I could get DMA to go)

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

Closed 2024-02-07.

Thread 49 (2024-02-12):

Can i plug NiteFury or LiteFury as a one sided board to Nvidia Jetson Orin Board using the m.2 connector ?

nimrodhagay, 2024-02-12:
Hi  ,

Can i plug NiteFury or LiteFury as a one sided board to Nvidia Jetson Orin Board using the m.2 connector ?

Thanks , Nimrod

Thread 53 (2024-03-31):

How to configure multiple DMA channels

mayureshw, 2024-03-31:
In xdma ip I have set the following property:

`xdma_rnum_chnl = 2`

This creates the additional bunch of h2c ports in the design. It creates additional ports related to MSI.

Just in case if that is causing any issue following property disables the formation of MSI ports.

`pf0_msi_enabled = false`

However, in either case, the xdma driver fails to recognize the device, with this design.

Has anyone successfully used multiple DMA channels and which specific properties of the IP were required to be configured for the same?

mayureshw, 2024-03-31:
Sorry, had just missed nitefury specific pin location constraints.

Closed 2024-03-31.

Thread 54 (2024-04-08):

Problem when configuring LiteFury with bin file from repo

jkjoulesys, 2024-04-08:
I have a LiteFury attached to a RPi 5 via a PCIE carrier board.  I'm using an XDMA driver from another project and everything works fine when I run using the factory default test image that came programmed into the LiteFury (lspci sees the card, I can load the driver and run test-general.py and test-ddr.py with no errors).  But if I load the FPGA via JTAG with the out.bin file from the repo (in Sample-Projects/Project-0/FPGA/LiteFury/mcs) I can still see the card with lspci but the driver will no longer load.  Should this work?  Is the image in the repo the same as the one that came programmed on the board?  I tried to do a verify, but this requires a mask file that's not in the repo.  Should it work if I load it via JTAG instead of booting from flash at power-on?

jkjoulesys, 2024-04-10:
Emailed the designer and got this...

Yes the binfile online should match what is programmed. Yeah the issue is that the PCIe device (the FPGA), must be up within 100ms of powerup (or reset). The motherboard looks for the device and enumerates it at this time.

Furthermore, if the link drops and comes back up, this usually results in an error where the device shows up in lspci but it won't work.

Some systems claim to be able to do a bus rescan, but I've never seen it work. Your best bet is to program your image into flash and have it ready at boot time. Make sure to use spi x4 mode just like the sample project so the bitstream can load in time.

Thread 55 (2024-04-17):

Device not showing up under lspci

LowEnergeticAg, 2024-04-17:
I have a NiteFury II, but it's only detected by lspci with the bitstream it came with and the one in the repo. When I tried to get my own project working with this configuration 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 it wouldn't show up under lspci. I also tried synthesizing the project from this repo myself, but this also didin't work.

RHSResearchLLC, 2024-04-18:
1. Make sure the constraints are taking effect (and make sure you are using the constraints from the depo. This is a common problem. There are other github issues that cover this, but basically under some circumstances Vivado doesn't respect the constraints- the pinout for PCIe. Look at your design schematic view in Vivado and make sure the PCIe pins out correctly.

See here for the constraints: https://github.com/RHSResearchLLC/NiteFury-and-LiteFury/tree/master/Sample-Projects/Project-0/FPGA/Nitefury-II/project/project.srcs/constrs_1/imports/constraints

Make sure early.xdc is setup to as "early" in Vivado- this is a separate step that must be taken. Otherwise Vivado uses the default constraints which aren't correct for this design. Another option is to add a 'reset' to the pinout before these early constraints, check out other github issues in this repo for details.

3. Are you loading your bitstream into flash? PCIe device needs to be ready within 100ms of powerup of the host. So programming your bitstream into fabric after the system is up, usually doesn't work. Your bitstream need to be in flash, or alternatively if you have a way to reset the host (rescan doesn't work- I mean a true full reset) without dropping power on the M.2 slot, that also works.

LowEnergeticAg, 2024-04-18:
Thanks for the reply. PCIe pins where in fact not mapped correctly and I was able to resolve the issue by setting the compile order for the constraints file with the PCIe pinout to early as you suggested.

Closed 2024-04-18.

Thread 56 (2024-04-22):

DRC errors with Vivado 2023.2

gonsolo, 2024-04-22:
I get the following errors using Vivado 2023.2 on Linux running build.tcl:

> ERROR: [DRC NSTD-1] Unspecified I/O Standard: 6 out of 6 logical ports use I/O standard (IOSTANDARD) value 'DEFAULT', instead of a user assigned specific value. This may cause I/O contention or incompatibility with the board power or connectivity affecting performance, signal integrity or in extreme cases cause damage to the device or the components to which it is connected. To correct this violation, specify all I/O standards. This design will fail to generate a bitstream unless all logical ports have a user specified I/O standard value defined. To allow bitstream creation with unspecified I/O standard values (not recommended), use this command: set_property SEVERITY {Warning} [get_drc_checks NSTD-1].  NOTE: When using the Vivado Runs infrastructure (e.g. launch_runs Tcl command), add this command to a .tcl file and add that file as a pre-hook for write_bitstream step for the implementation run. Problem ports: code[2:0], clk, led, and ok.

> ERROR: [DRC UCIO-1] Unconstrained Logical Port: 6 out of 6 logical ports have no user assigned specific location constraint (LOC). This may cause I/O contention or incompatibility with the board power or connectivity affecting performance, signal integrity or in extreme cases cause damage to the device or the components to which it is connected. To correct this violation, specify all pin locations. This design will fail to generate a bitstream unless all logical ports have a user specified site LOC constraint defined.  To allow bitstream creation with unspecified pin locations (not recommended), use this command: set_property SEVERITY {Warning} [get_drc_checks UCIO-1].  NOTE: When using the Vivado Runs infrastructure (e.g. launch_runs Tcl command), add this command to a .tcl file and add that file as a pre-hook for write_bitstream step for the implementation run.  Problem ports: code[2:0], clk, led, and ok.

Any advice?

makslevental, 2024-04-29:
Did you manage to figure this out?

gonsolo, 2024-04-30:
Yes. I manually fixed the ports (clk, led, ok) in Vivado.

makslevental, 2024-04-30:
> Yes. I manually fixed the ports (clk, led, ok) in Vivado.

Which `IOSTANDARD` did you set?

gonsolo, 2024-04-30:
Ha, hard to remember after one week. :roll_eyes:
I just played around until it worked but I *believe* it was just a matter of setting it explicitly to the default. I have no idea why that would make a difference.

Closed 2024-04-30.

Thread 57 (2024-05-23):

UART/IO Pins

HashFail, 2024-05-23:
Hello, I'm looking for confirmation as to which pins correspond to the I/O pins.

From reading the schematic, Page 9, it seems like they should be

VCC:
I/O 0: H5
I/O 1: J5
I/O 2: J2
I/O 3: K2
GND:

With VCC at the top if one is looking at the board with the I/O bank above the JTAG bank.

Are these pins correct? If so, does it matter which is used for UART transmit/receive? Or can any pin be used for any purpose, either input and output?

HashFail, 2024-05-27:
These settings appear to be correct. Using the above pins in my constraints file produces the desired output. Closing.

Closed 2024-05-27.

Thread 59 (2024-08-15):

Unspecified I/O Standard: [...] Problem ports: code[2:0], clk, led, and ok.

milannedic, 2024-08-15:
Hello,

Ubuntu 20.04.x + Vivado 2022.1 user here (same result on Vivado 2023.1 as well)
I recently bought Nitefury board and I am having problems regenerating bitstream from sample project from this repo.

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

Does anyone have an idea how to get over this? How can I add additional constraints to solve this?
Here is the location of mentioned ports:
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

Clock comes from MIG
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

Existing constraints are default constraints from this repo, no changes.
https://github.com/RHSResearchLLC/NiteFury-and-LiteFury/tree/master/Sample-Projects/Project-0/FPGA/common/Constraints

Thank you for your help.

milannedic, 2024-08-15:
[https://github.com/RHSResearchLLC/NiteFury-and-LiteFury/issues/56](url)

I now see the same topic listed under Closed issues. Unfortunately, poster doesnt remember how exactly this issue was solved. So, someone please share their ideas. Big thanks

Thread 60 (2024-10-29):

Out of stock

danielzgtg, 2024-10-29:
It says the Nitefury is "SOLD OUT" since [April](https://web.archive.org/web/20240412133709/https://rhsresearch.com/collections/rhs-public/products/nitefury-xilinx-artix-fpga-kit-in-nvme-ssd-form-factor-2280-key-m) and [June](https://web.archive.org/web/20240620210110/https://rhsresearch.com/collections/rhs-public/products/nitefury-xilinx-artix-fpga-kit-in-nvme-ssd-form-factor-2280-key-m) 2024. When will it be back in stock? For how many years will it be guaranteed to be in production until at least?

RHSResearchLLC, 2024-10-29:
Hello,

There are some on Amazon still, but once those are gone, they will likely
be out of stock forever. I'm not producing any more

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

danielzgtg, 2024-10-30:
Oh no :(. The other M.2 FPGA on Google is like $500, a 250% increase, overpriced for new grads. NiteFury was the highest LUT count per dollar I could find...

Amazon says "Temporarily out of stock." Based on what you said, I placed an order anyway, hoping it will go through.

RHSResearchLLC, 2024-10-30:
Yeah I got a good deal on FPGAs but it's not worth the outlay to make
another batch. Id probably have to charge $350/ea on the next batch to make
it worthwhile. Even then, these don't sell quickly, so it's a large outlay
and a slooow return.

There are plenty of Litefury in stock, it's not very popular even given the
price. But as a tool to experiment with PCIe on FPGA, Litefury is a good
deal

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

timkpaine, 2025-03-30:
I've done a bunch of research in this area and I think i might've been the one to purchase the last few (sorry!). Its more expensive, but this board is also good for the price, though the price is much higher: https://www.en.alinx.com/Product/FPGA-Development-Boards/Kintex-7/AX7325B.html

I have not used this board, but it is similar (again, more expensive): https://numato.com/product/aller-artix-7-fpga-board-with-m-2-interface/

Education discount is available (https://numato.com/academic-open-source/#:~:text=We%20do%20offer%20a%20minimum,discounts%20or%20even%20free%20products.).

Closed 2024-10-30.

Thread 61 (2025-03-30):

Amaranth-based basic example

timkpaine, 2025-03-30:
Here is a simple [amaranth](https://github.com/amaranth-lang/amaranth)-based design. Note that you need [this pull request](https://github.com/amaranth-lang/amaranth-boards/pull/256), and ideally  [openFPGALoader](https://github.com/trabucayre/openFPGALoader).

```python
from amaranth_boards.nitefury import NitefuryIIPlatform
from amaranth import Elaboratable, Module, Signal, Cat
from amaranth.lib import io

class Chaser(Elaboratable):
    def elaborate(self, platform):
        m = Module()

        clk_freq = platform.default_clk_frequency

        leds = [io.Buffer("o", platform.request("led", i, dir="-")) for i in range(4)]
        m.submodules += leds

        timer = Signal(range(int(clk_freq//8)), init=0)
        flop_1 = Signal(1, init=1)
        flop_2 = Signal(1, init=1)
        flop_3 = Signal(1, init=1)
        flop_4 = Signal(1, init=0)

        m.d.comb += Cat(led.o for led in leds).eq(Cat(flop_1, flop_2, flop_3, flop_4))

        with m.If(timer == 0):
            m.d.sync += flop_1.eq(flop_4)
            m.d.sync += flop_2.eq(flop_1)
            m.d.sync += flop_3.eq(flop_2)
            m.d.sync += flop_4.eq(flop_3)
        m.d.sync += timer.eq(timer + 1)
        return m

NitefuryIIPlatform().build(Chaser(), do_program=True)
```

Here is a design with some embedded systemverilog:

```python
from amaranth_boards.nitefury import NitefuryIIPlatform
from amaranth import (
    Elaboratable,
    Module,
    Instance,
    ClockSignal,
    ResetSignal,
    Signal,
    Cat,
)
from amaranth.lib import io

VERILOG_SOURCE = """
module counter #(parameter DATA_SIZE) (
  input clk,
  input rst,
  output logic[DATA_SIZE:0] out
);

  always_ff @ (posedge clk) begin
    if (rst)
      out <= 0;
    else
      out <= out + 1;
  end
endmodule
"""

class Chaser(Elaboratable):
    def elaborate(self, platform):
        m = Module()

        clk_freq = platform.default_clk_frequency

        leds = [io.Buffer("o", platform.request("led", i, dir="-")) for i in range(4)]
        m.submodules += leds

        size = range(int(clk_freq // 8))
        timer = Signal(size, init=0)
        flop_1 = Signal(1, init=1)
        flop_2 = Signal(1, init=1)
        flop_3 = Signal(1, init=1)
        flop_4 = Signal(1, init=0)

        m.submodules.counter = Instance(
            "counter",
            i_clk=ClockSignal(),
            # i_rst=ResetSignal(),
            o_out=timer,
            p_DATA_SIZE=timer.shape().width-1,
        )

        platform.add_file("counter.sv", VERILOG_SOURCE)
        m.d.comb += Cat(led.o for led in leds).eq(Cat(flop_1, flop_2, flop_3, flop_4))

        with m.If(timer == 0):
            m.d.sync += flop_1.eq(flop_4)
            m.d.sync += flop_2.eq(flop_1)
            m.d.sync += flop_3.eq(flop_2)
            m.d.sync += flop_4.eq(flop_3)

        # m.d.sync += timer.eq(timer + 1)
        return m

NitefuryIIPlatform().build(Chaser(), do_program=True)
```

Closed 2025-03-30.

Thread 62 (2025-04-30):

How to detach the jtag header?

mayureshw, 2025-04-30:
Is there any how to or a video about detaching, without damaging, the jtag connector wire?

Thread 63 (2025-06-17):

Vivado 2024.2 Errors

Tyberious, 2025-06-17:
Any chance you can update the sample project and constraints to 2024.2?

Thread 64 (2025-08-27):

Gerber Files

CueMaxX, 2025-08-27:
Hi,
since I cannot find the board anywhere for sale, could you please provide gerber files, BOM and CPL/P&P so we can order it from an online PCB manufacturer? Thank you :)
