RHSResearchLLC/NiteFury-and-LiteFury/Hardware/uEVB-Block-Diagram.pdf

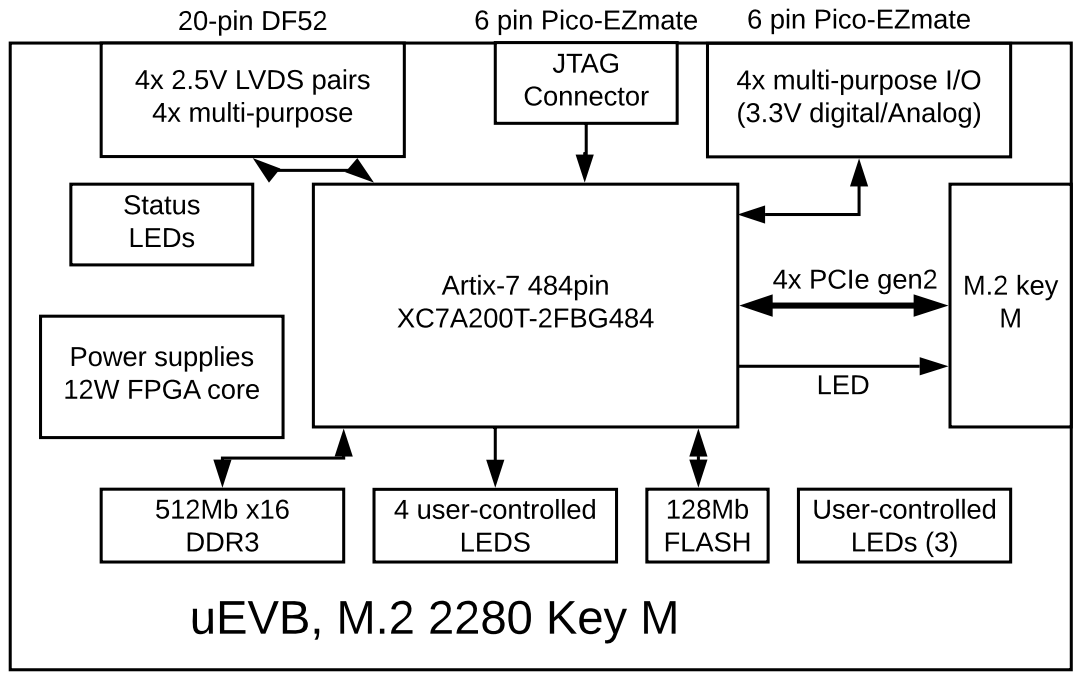
[picture p13: page 1]
uEVB, M.2 2280 Key M; Artix-7 484pin XC7A200T-2FBG484; 4 user-controlled LEDS; JTAG Connector; M.2 key M; 4x PCIe gen2; 4x 2.5V LVDS pairs 4x multi-purpose; 512Mb x16 DDR3; Status LEDs; Power supplies 12W FPGA core; 128Mb FLASH; LED; 4x multi-purpose I/O (3.3V digital/Analog); 20-pin DF52; 6 pin Pico-EZmate; User-controlled LEDs (3)
