RHSResearchLLC/NiteFury-and-LiteFury/(commit log)

2018-04-30 Early schematic and Vivdo files
2018-05-08 updated schematic
2018-05-26 Updated per current design
2018-06-11 baseline checkin. TnD blinks LEDs based on clocks
2018-06-17 safety checkin. Trying new AXI connector to try and eliminate timing failures. didn't work
2018-06-20 (temporarily) adding driver files. Also adding memory tester
2018-06-21 Fixed DDR LED indicator
2018-07-25 Updated schematic for rev A4
2018-08-23 Adding sample project 0 for A100T part
2019-04-24 Updated schematic to match current hardware
2019-11-16 Initial SPI loader checkin
2019-11-29 Added BOM
    [uEVB-BOM-Z3.xlsx]
2022-08-06 Fixing build-moving to common constraints
    [early.xdc, normal.xdc]
2022-08-12 Fixing landing page documentation
2022-08-13 Rebuilt spi-loader binary for version 1.5
